Xinyuan-LilyGO/T-Echo/firmware/README.MD

<div align="center" markdown="1">
  LilyGo logo
</div>

<h1 align = "center">🌟 T-Echo Firmware 🌟</h1>

## 📖 Table of Contents

- [📖 Table of Contents](#-table-of-contents)
- [📋 Firmware Overview](#-firmware-overview)
- [📁 Firmware Directory Structure](#-firmware-directory-structure)
- [🔄 How to Update Firmware](#-how-to-update-firmware)

---

## 📋 Firmware Overview

| Firmware File | Description |
| :--- | :--- |
| `factory-xxx.uf2` | Includes LoRa transceiver, BLE connection, and all hardware test items. For BLE testing, download [nRF Connect](https://www.nordicsemi.com/Products/Development-tools/nrf-connect-for-mobile) from Google Play or Apple App Store. |
| `gps_factory.uf2`  | Used to diagnose hardware issues and test GPS functionality. |

---

## 📁 Firmware Directory Structure

```
firmware/
├── factory
│   ├── SoftRF-firmware-v1.3-nRF52.uf2      # SoftRF factory pre-flashed version
│   └── firmware-t-echo-inkhud-2.7.13.uf2   # Meshtastic factory pre-flashed version
├── factory-debug.uf2   # Factory test firmware
├── factory.uf2         # Factory debug test firmware
├── gps_factory.uf2     # GPS NMEA output firmware
```
> [!TIP]
> `factory-debug.uf2` prevents the device from booting until a serial monitor is connected. The device will not start unless a serial monitor is attached; once connected, it will begin booting and outputting diagnostic logs. Please note that for most serial monitors, you must enable the **DTR** option to view the logs output by the T-Echo. The serial monitor baud rate should be set to 115200.
> 

---

## 🔄 How to Update Firmware

1. Connect the device to your computer using a USB-C to USB-A cable (do not use USB-C to USB-C).
2. Double-click the top-left button on the device. If it doesn't work, try again.
3. Once the device disk appears on your computer, drag the `*.uf2` firmware file onto the disk and wait for the file to copy.
4. The device will boot normally.
