Xinyuan-LilyGO/T-Echo/dimensions/README.md

# T-BHI260-ICM29048

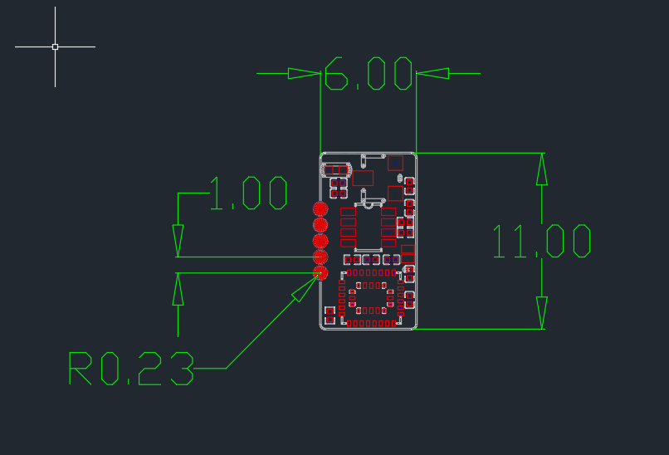
[picture p8: dimensions/T-BHI260.png]
T-BHI260


# T-Echo-Plus

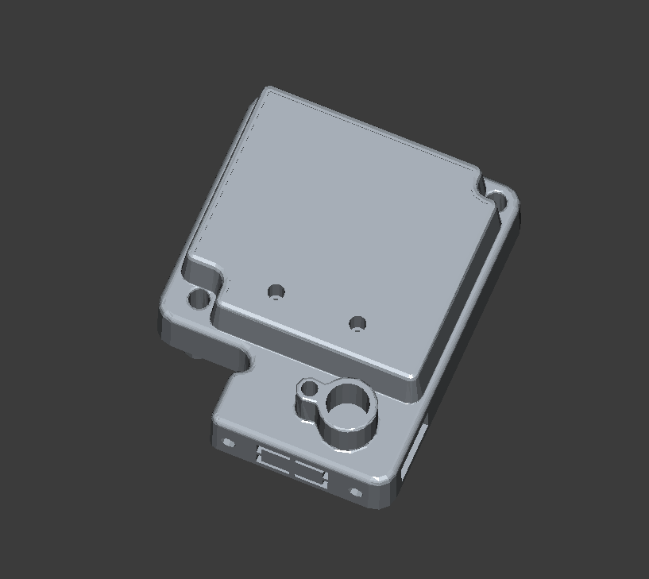
[picture p9: dimensions/t-echo-plus-back-cover.png]
t-echo-plus-back-cover


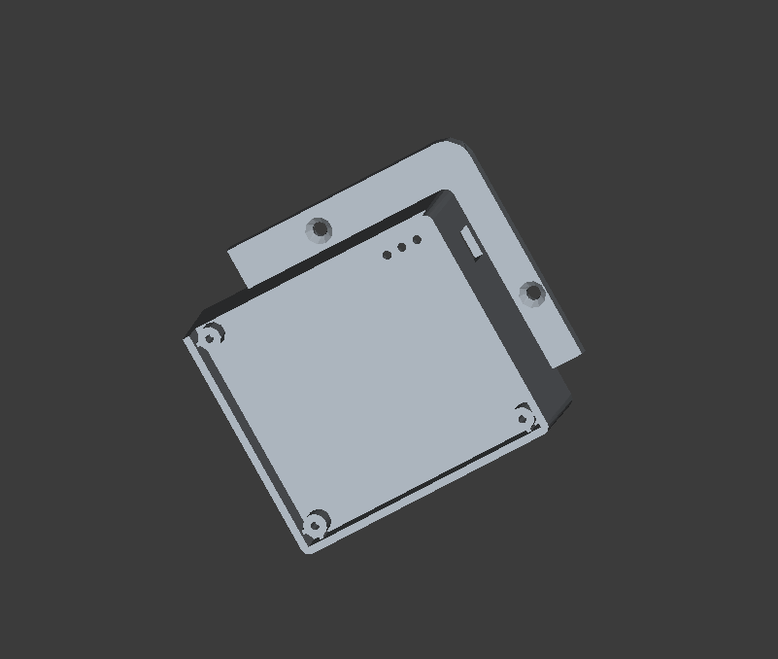
[picture p10: dimensions/t-echo-plus-middle-frame.png]
t-echo-plus-middle-frame
