Xinyuan-LilyGO/T-Echo/uf2/README.MD

- CURRENT.UF2 is placed here as a backup of t-echo [Refer to this issue](https://github.com/cfr34k/t-echo-lora-aprs/issues/30#issuecomment-3091227024)
