Xinyuan-LilyGO/T-Echo/examples/SoftRF_firmware/README.MD

<h1 align = "center">🌟LilyGo T-ECHO🌟</h1>

Double-click the reset button to pull the file into the popover's directory

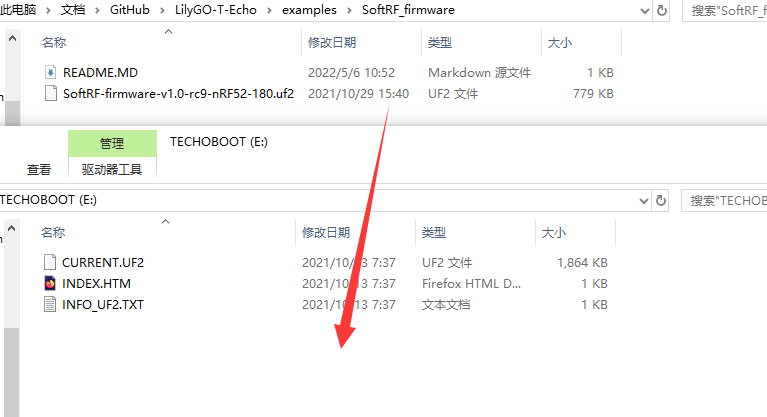
[picture p13: image/drag.png]


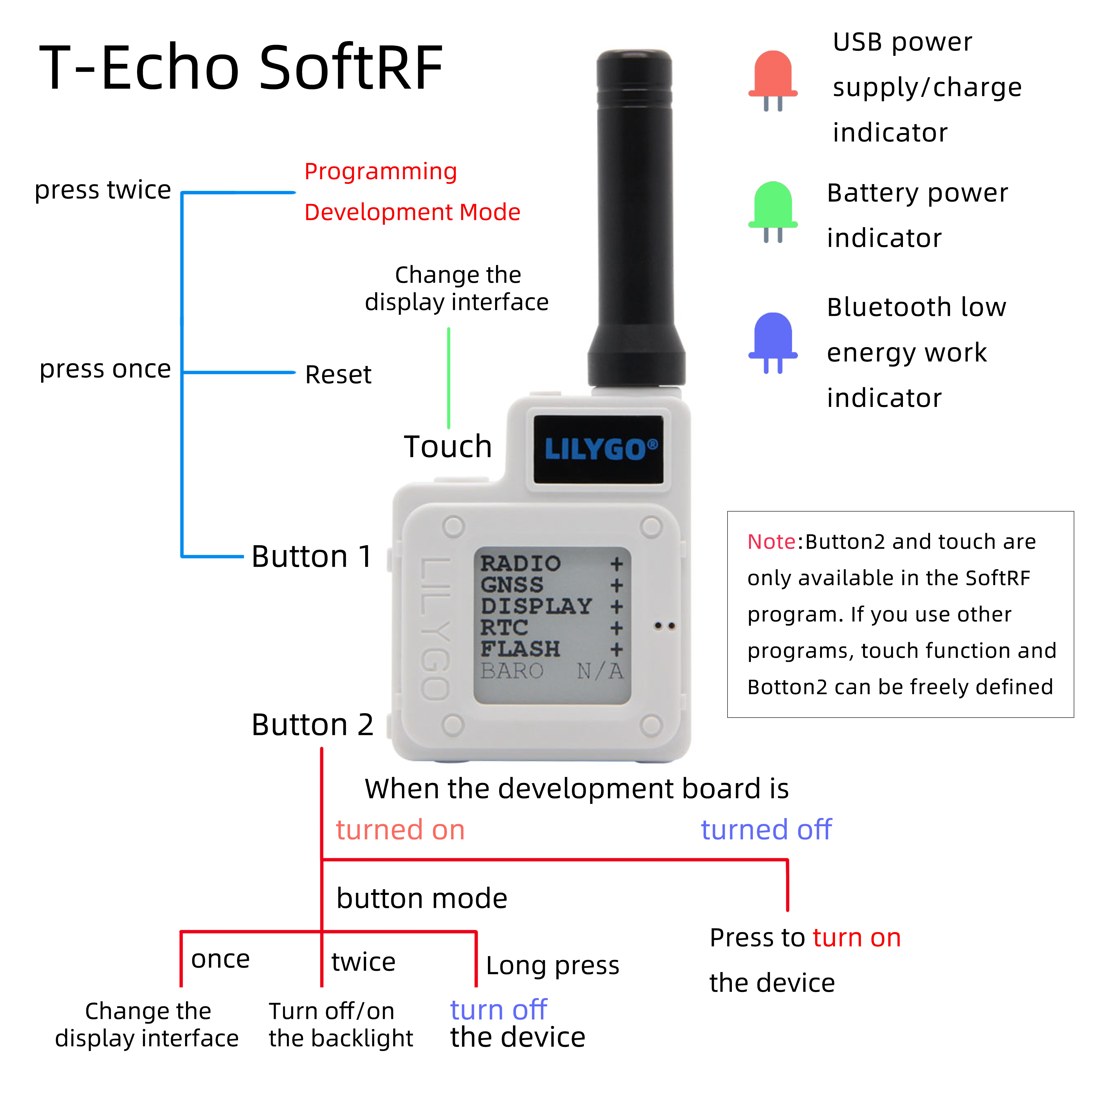
[picture p14: image/T-Echo_SoftRF.jpg]


- [T-Echo SoftRF](https://github.com/lyusupov/SoftRF)
- [T-Echo SoftRF Wiki](https://github.com/lyusupov/SoftRF/wiki/Badge-Edition)
