Xinyuan-LilyGO/T-Echo/examples/LoraReceive/README.MD

<h1 align = "center">🌟LilyGo T-ECHO🌟</h1>

This test requires two devices, one for the sender and the other for the receiver.Here is an example of the receiver.The serial output is as follows.
