Xinyuan-LilyGO/T-Echo/examples/LoraTransmit/README.MD

<h1 align = "center">🌟LilyGo T-ECHO🌟</h1>

This test requires two devices, one for the sender and the other for the receiver.Here's an example of the sending side.The serial output is as follows.
