Xinyuan-LilyGO/T-Echo/examples/GPS/README.MD

<h1 align = "center">🌟LilyGo T-ECHO🌟</h1>

This is a simple test of GPS, hook up the GNSS antenna.The output of successfully locating the serial port is as follows

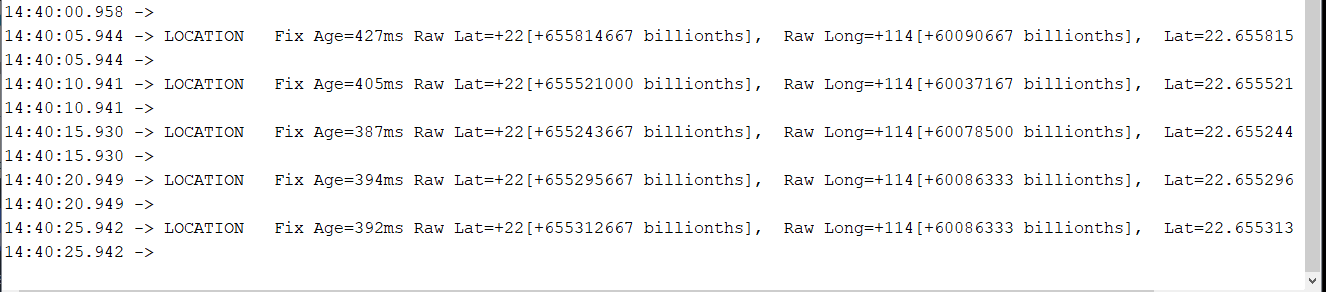
[picture p15: image/GPS.png]
