Xinyuan-LilyGO/T-Echo/examples/Sleep/readme.MD

<h1 align = "center">🌟LilyGo T-ECHO🌟</h1>
1. Long press the UserButton to sleep
2. Click and touch wake up
