Xinyuan-LilyGO/T-Echo/examples/Meshtastic_firmware/README.MD

<h1 align = "center">🌟LilyGo T-ECHO🌟</h1>

### Double-click reset to operate as shown in the figure below

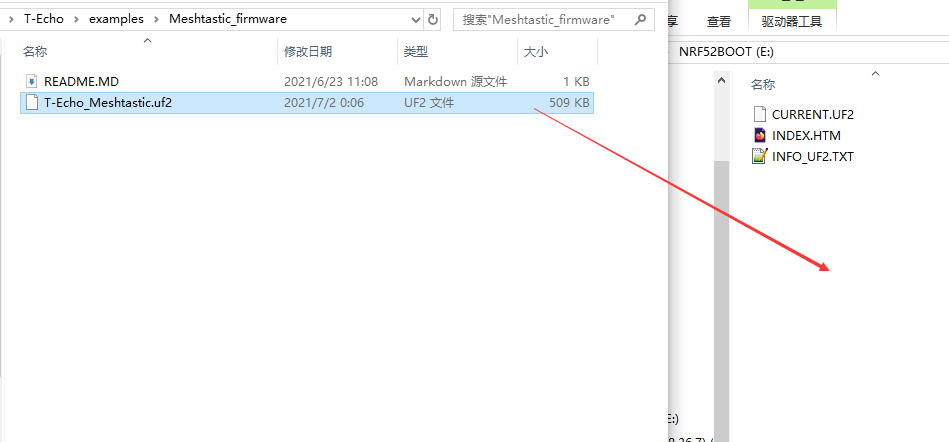
[picture p16: image/Meshtastic_pull.png]


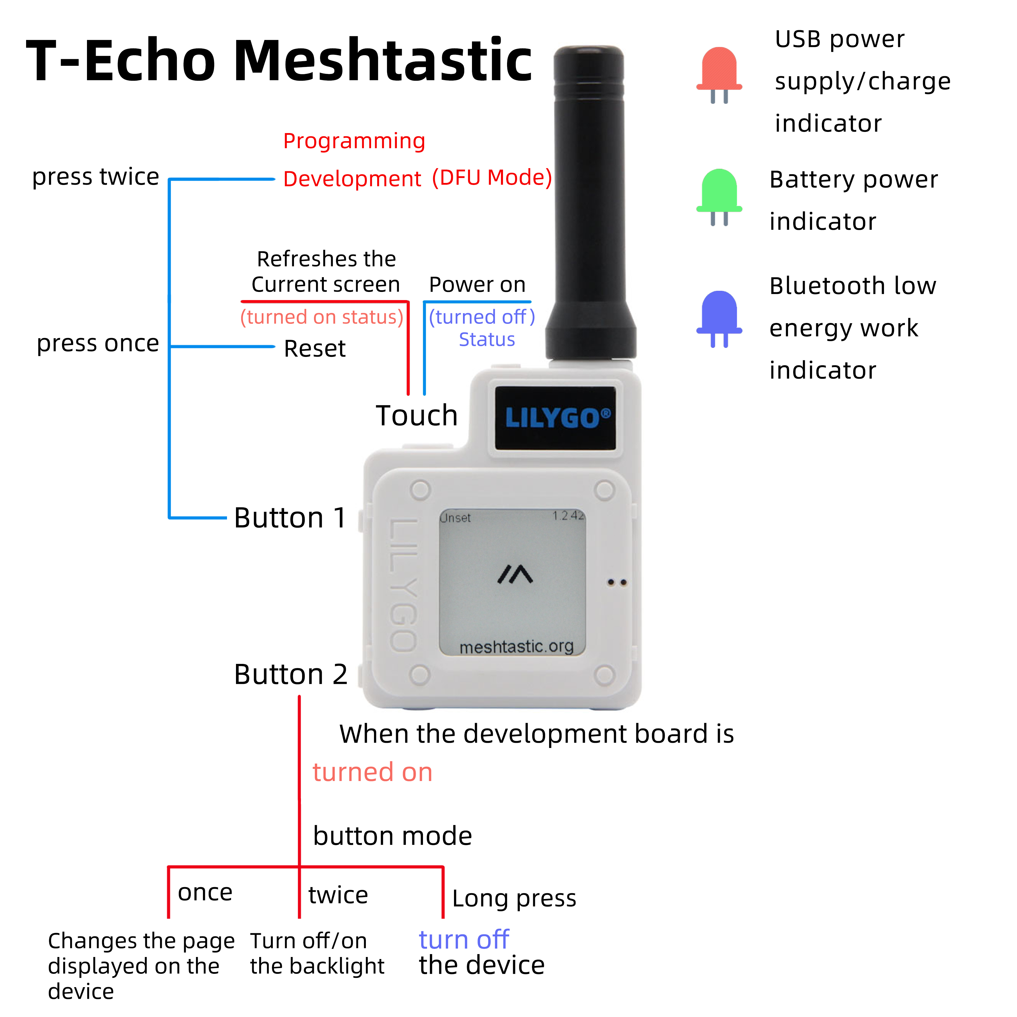
[picture p17: image/T-ECHO_Mesh.jpg]

- [T-Echo Meshtastic](https://github.com/meshtastic/Meshtastic-device/tree/v1.2.42.2759c8d)
- [T-Echo Meshtastic Doc](https://meshtastic.org/docs/getting-started)
- [T-Echo Meshtastic Android application usage](https://meshtastic.org/docs/software/android/android-usage)
