Xinyuan-LilyGO/T-Echo/image/lora_rx.png

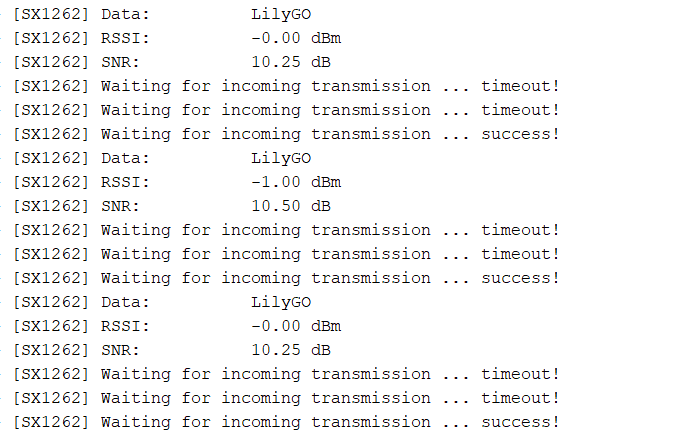
image/lora_rx.png
