Xinyuan-LilyGO/T-Echo/image/lora_tx.png

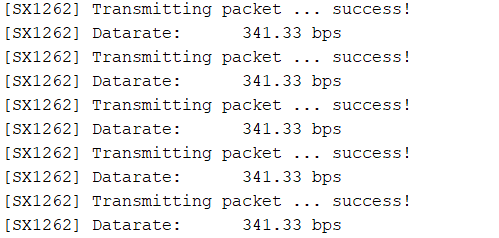
image/lora_tx.png
