Xinyuan-LilyGO/T-Echo/dimensions/T-BHI260-ICM29048.dxf

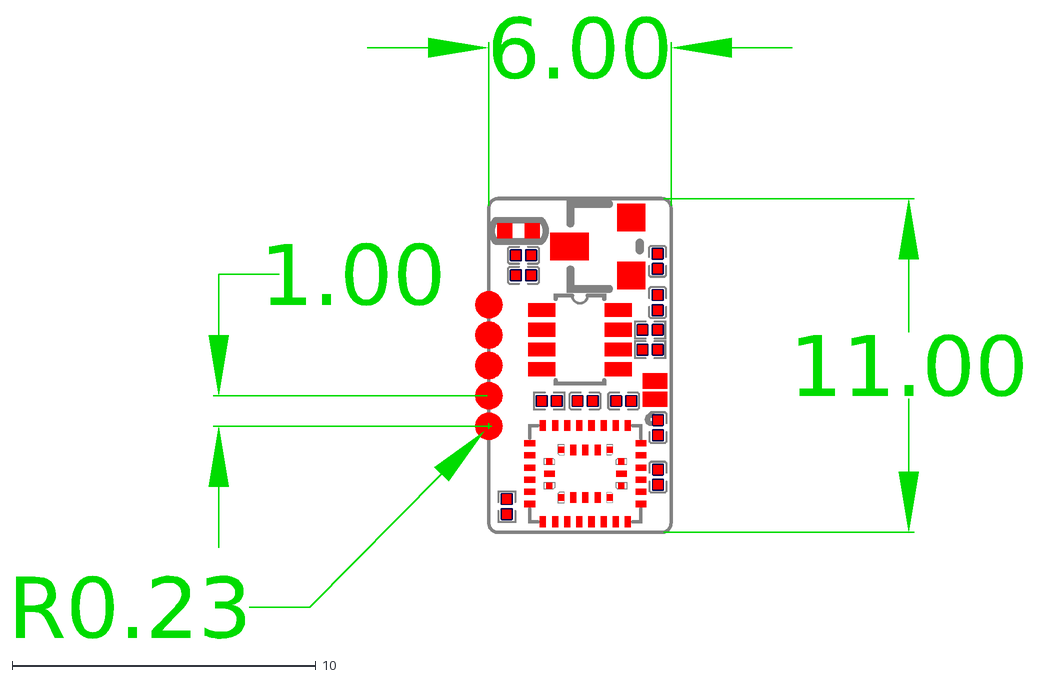
[picture p21: CAD file, 2025-06-24]
dimensions/T-BHI260-ICM29048.dxf
6.00
R0.23
11.00
1.00
