Xinyuan-LilyGO/T-Echo/dimensions/t-echo_3d.stl

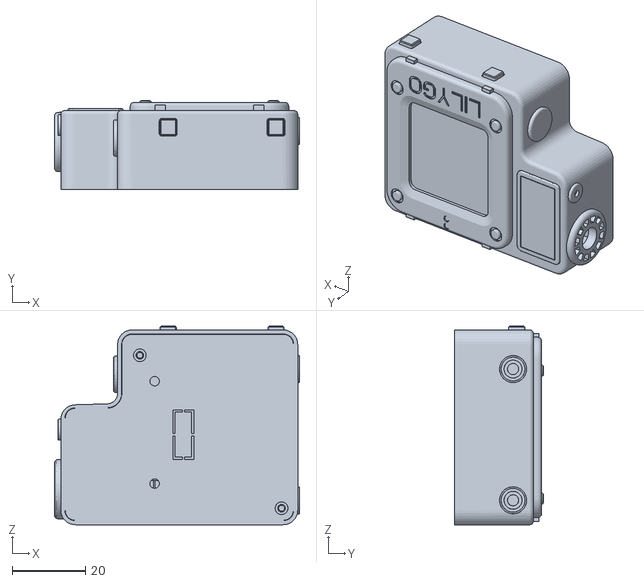
[picture p22: CAD file, 2022-05-06]
dimensions/t-echo_3d.stl
67.0 x 24.2 x 54.3
