Xinyuan-LilyGO/T-Echo/(threads)

Thread 1 (2021-08-01):

Arduino configuration for LoRa transmit program

F4EWI, 2021-08-01:
I just received my T-Echo. I need a little help setting up my development environment correctly.
1) Installation of libraries

- **PCF8563_Library** -> can you give more details on which to use (link, version,...)?
- Same remark for the **SoftSPI** and **SerialFlash_ID539** ?

2) Compilation error

Arduino: 1.8.15 (Windows 10), Board: "Nordic nRF52840DK (PCA10056), S140 6.1.1, Level 0 (Release)"
Transmit:17:10: fatal error: GxDEPG0150BN/GxDEPG0150BN.h: No such file or directory
   17 | #include <GxDEPG0150BN/GxDEPG0150BN.h>  // 1.54" b/w
      |          ^~~~~~~~~~~~~~~~~~~~~~~~~~~~~
compilation terminated.
exit status 1

GxDEPG0150BN/GxDEPG0150BN.h: No such file or directory

On my folder : C:\Users\HP\Documents\Arduino\libraries\GxEPD\src, I don't have this folder !

LilyGO, 2021-08-03:
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

The GxDEPG0150BN driver has been added. In [LilyGO-T-Echo/lib/GxEPD /](https://github.com/Xinyuan-LilyGO/LilyGO-T-Echo/tree/main/lib/GxEPD)

Closed 2021-09-02.

Thread 2 (2021-09-06):

LoRaWAN support

hkicko, 2021-09-06:
Could you please add an example using LoRaWAN?
I found 2 libraries that support this radio -
https://github.com/LacunaSpace/basicmac
and
https://github.com/ngraziano/LMICPP-Arduino
BasicMac seems more promising. But if I try to use it, it fails the assert in this method in radio-ax126x.c:
```
// reset radio
static void radio_reset (void) {
    // drive RST pin low
    bool has_reset = hal_pin_rst(0);

    // If reset is not connected, just continue and hope for the best
    if (!has_reset)
        return;

    // wait > 100us
    hal_waitUntil(os_getTime() + ms2osticks(1));

    // configure RST pin floating
    hal_pin_rst(2);

    // wait 1ms?
    hal_waitUntil(os_getTime() + ms2osticks(1));

    // check reset value
    ASSERT( ReadReg(REG_LORASYNCWORDLSB) == 0x24 );

    // initialize state
    state.sleeping = 0;
}
```

FabTangi, 2021-09-10:
could you also confirm this device can be used on The Things Industries / Networks ?

hkicko, 2021-09-10:
Yes, that's the goal - to use it as a mapper for Helium or TTN.

LilyGO, 2021-09-13:
Hello, thank you for your proposal. We are increasing the support of loRaWAN for T-Echo. If you gain anything, you are welcome to contribute to T-Echo.

wbefield, 2022-01-14:
I have a T-echo and would like to use it on the Helium network Mapper

MAY4VFX, 2023-12-03:
> https://github.com/Xinyuan-LilyGO/T-Echo/tree/main/examples/LoRaWAN
such a path does not exist, does T-echo TTN support any news?

Closed 2022-07-12.

Thread 3 (2021-09-10):

DeepSleep power consumption

FabTangi, 2021-09-10:
Can we have detailed infos on the power consumption of the product? (working / deepsleep)

LilyGO, 2021-09-11:
Working current: refer to https://github.com/lyusupov/SoftRF/wiki/Badge-Edition#battery-life
Sleep current: about 0.25mA

FabTangi, 2021-09-13:
Thanks for your answer. I was expecting a few microA, according to datasheets of components. Do you have plan to reduce the consumption in deep-sleep?

LilyGO, 2021-10-19:
Hi, There are no plans, and its sleep power consumption is already very low

Llgok, 2024-09-09:
> Thanks for your answer. I was expecting a few microA, according to datasheets of components. Do you have plan to reduce the consumption in deep-sleep?

@FabTangi
Hello, the latest low-power example has been updated. You can try using the example [Sleep\_Display](./examples/Sleep_Display) to reduce the power consumption of your onboard board.

Closed 2021-10-19.

Thread 5 (2021-11-11):

Error with lib/SoftSPI: Missing 'paragraph' from library

runestone74, 2021-11-11:
When starting Arduino I get this error (after adding the files from /lib to \Arduino\libraries) SoftSPI: Missing 'paragraph' from library

LilyGO, 2021-11-16:
[Download and unzip to the library](https://github.com/MajenkoLibraries/SoftSPI)

Closed 2021-11-16.

Thread 6 (2021-11-16):

Source code for the t-echo 1.2.42.753ae00-d.uf2 firmware

runestone74, 2021-11-16:
Hi, I am sorry but I can't find the source code.

runestone74, 2021-11-16:
We are eager to get the "reset without USB-power" working again :)

LilyGO, 2021-11-18:
[Reference](https://github.com/meshtastic/Meshtastic-device)

runestone74, 2021-11-19:
Thanks, I was searching for the source for this specific release: 1.2.42.753ae00-d where the "magic" reset button works as intended. Now it just works when USB power is plugged in. The UF2 files is available for download, but not the source code.

LilyGO, 2021-11-20:
This is the source code for Meshtastic .  [Reference](https://github.com/meshtastic/Meshtastic-device)

runestone74, 2021-11-21:
Yes but I can't find this specific release, do you have a direct link?

LilyGO, 2021-11-22:
[Reference](https://github.com/meshtastic/Meshtastic-device/releases)

runestone74, 2022-01-27:
There is no source code on github for release 1.2.42.753ae00-d can you search your backups and see if it turns up? :)

runestone74, 2022-02-02:
It seems like the GPS functionality is working much more reliable as well. Can you please publish this source code, thanks!

mkinney, 2022-02-04:
There are two software components: the bootloader (which is developed by the manufacturer LilyGO) and the firmware (could be made by anyone). I think, based on the version you're referencing, and the fact that they're pointing you to Meshtastic, I think you're looking for something like this: https://github.com/meshtastic/Meshtastic-device/releases/tag/v1.2.42.2759c8d

which is not made by LilyGo. It is made by the Meshtastic project (all volunteers)

However, that's fairly old in Meshtastic timeline. If you want to update to the latest, check out https://github.com/meshtastic/Meshtastic-device/releases/tag/v1.2.53.19c1f9f (or maybe the beta)

runestone74, 2022-02-09:
Still no source from LilyGO, with the changes that makes the T-Echo able to wake from sleep/reset . Also probably some other GPS communication as well. Yes, we understand that you might not want to share the sourcecode, but could you please point us in the right direction in the way it should work, but dont. That would be appreciated.

mkinney, 2022-02-10:
Check out this answer: https://github.com/Xinyuan-LilyGO/LilyGO-T-Echo/issues/9#issuecomment-1034425178

mc-hamster, 2022-04-19:
@runestone74 here you go:

https://github.com/geeksville/Meshtastic-esp32/commit/753ae00

Closed 2022-03-21.

Thread 7 (2021-11-22):

Drawing text on epaper display

CharlesMod, 2021-11-22:
Hello,

I've been trying for some time to successfully show text on the display, can you provide an example that shows how to do this?

LilyGO, 2021-11-22:
Here is a simple display  [example](https://github.com/Xinyuan-LilyGO/LilyGO-T-Echo/blob/main/examples/Display_lilygo/Display_lilygo.ino)

CharlesMod, 2021-11-22:
Thank you for your quick response!

I have already tried this example, trouble is it only shows bitmap print feature, not text print feature. Can you provide a different example?

CharlesMod, 2021-11-22:
FYI tested the following, just makes the code hang when included in the example you provided:

`  display->setRotation(2);
  display->fillScreen(GxEPD_WHITE);
  display->setTextColor(GxEPD_BLACK);
  display->setFont(&FreeSansBold9pt7b);
  display->setCursor(0, 45);
  display->print("Hello World"); //crashes here
  display->update();`

LilyGO, 2021-11-22:
void setup()
{
    Serial.begin(115200);
    delay(200);
    boardInit();
    delay(200);
    LilyGo_logo();
/*************************************************/
delay(200);
display->setRotation(3);
display->fillScreen(GxEPD_WHITE);
display->setTextColor(GxEPD_BLACK);
display->setFont(&FreeMonoBold12pt7b);
display->setCursor(0, 45);
display->print("Hello World"); //crashes here
display->update();
/*************************************************/
}

CharlesMod, 2021-11-22:
Hm no dice, the //crashes here line when uncommented breaks the sketch, the RGB blinking stops

Here is the full code, does it work on a unit you have there?

```
/*
  Display lilygo logo example

  This example shows an e-Peper display.The RGB indicator blinks in cycles.

  This example code is in the public domain.
*/

#include "utilities.h"
#include <SPI.h>
#include <Wire.h>

#include <GxEPD.h>
//#include <GxGDEP015OC1/GxGDEP015OC1.h>    // 1.54" b/w
//#include <GxGDEH0154D67/GxGDEH0154D67.h>  // 1.54" b/w
#include <GxDEPG0150BN/GxDEPG0150BN.h>  // 1.54" b/w

#include GxEPD_BitmapExamples
#include <Fonts/FreeMonoBold12pt7b.h>
#include <GxIO/GxIO_SPI/GxIO_SPI.h>
#include <GxIO/GxIO.h>

void setupDisplay();
void enableBacklight();
void configVDD(void);
void boardInit();
void LilyGo_logo(void);

SPIClass        *dispPort  = nullptr;
SPIClass        *rfPort    = nullptr;
GxIO_Class      *io        = nullptr;
GxEPD_Class     *display   = nullptr;

uint32_t        blinkMillis = 0;
uint8_t rgb = 0;

void setup()
{
  Serial.begin(115200);
  delay(200);
  boardInit();
  delay(200);
  LilyGo_logo();
  delay(200);
  display->setRotation(3);
  display->fillScreen(GxEPD_WHITE);
  display->setTextColor(GxEPD_BLACK);
  display->setFont(&FreeMonoBold12pt7b);
  display->setCursor(0, 45);
  display->print("Hello World"); //crashes here
  display->update();
}

void loop()
{

  if (millis() - blinkMillis > 1000) {

    blinkMillis = millis();
    switch (rgb) {
      case 0:
        digitalWrite(GreenLed_Pin, LOW);
        digitalWrite(RedLed_Pin, HIGH);
        digitalWrite(BlueLed_Pin, HIGH);
        break;
      case 1:
        digitalWrite(GreenLed_Pin, HIGH);
        digitalWrite(RedLed_Pin, LOW);
        digitalWrite(BlueLed_Pin, HIGH);
        break;
      case 2:
        digitalWrite(GreenLed_Pin, HIGH);
        digitalWrite(RedLed_Pin, HIGH);
        digitalWrite(BlueLed_Pin, LOW);
        break;
      default :
        break;
    }
    rgb++;
    rgb %= 3;
  }
}

void LilyGo_logo(void)
{

  display->fillScreen(GxEPD_WHITE);
  display->drawExampleBitmap(BitmapExample1, 0, 0, GxEPD_WIDTH, GxEPD_HEIGHT, GxEPD_BLACK);
  display->update();
}

void enableBacklight(bool en)
{
  digitalWrite(ePaper_Backlight, en);
}

void setupDisplay()
{
  dispPort = new SPIClass(
    /*SPIPORT*/NRF_SPIM2,
    /*MISO*/ ePaper_Miso,
    /*SCLK*/ePaper_Sclk,
    /*MOSI*/ePaper_Mosi);

  io = new GxIO_Class(
    *dispPort,
    /*CS*/ ePaper_Cs,
    /*DC*/ ePaper_Dc,
    /*RST*/ePaper_Rst);

  display = new GxEPD_Class(
    *io,
    /*RST*/ ePaper_Rst,
    /*BUSY*/ ePaper_Busy);

  dispPort->begin();
  display->init(/*115200*/);
  display->setRotation(2);
  display->fillScreen(GxEPD_WHITE);
  display->setTextColor(GxEPD_BLACK);
  display->setFont(&FreeMonoBold12pt7b);
}

void configVDD(void)
{
  // Configure UICR_REGOUT0 register only if it is set to default value.
  if ((NRF_UICR->REGOUT0 & UICR_REGOUT0_VOUT_Msk) ==
      (UICR_REGOUT0_VOUT_DEFAULT << UICR_REGOUT0_VOUT_Pos)) {
    NRF_NVMC->CONFIG = NVMC_CONFIG_WEN_Wen;
    while (NRF_NVMC->READY == NVMC_READY_READY_Busy) {}

    NRF_UICR->REGOUT0 = (NRF_UICR->REGOUT0 & ~((uint32_t)UICR_REGOUT0_VOUT_Msk)) |
                        (UICR_REGOUT0_VOUT_3V3 << UICR_REGOUT0_VOUT_Pos);

    NRF_NVMC->CONFIG = NVMC_CONFIG_WEN_Ren;
    while (NRF_NVMC->READY == NVMC_READY_READY_Busy) {}

    // System reset is needed to update UICR registers.
    NVIC_SystemReset();
  }
}

void boardInit()
{

  uint8_t rlst = 0;

#ifdef HIGH_VOLTAGE
  configVDD();
#endif

  SerialMon.begin(MONITOR_SPEED);
  // delay(5000);
  // while (!SerialMon);
  SerialMon.println("Start\n");

  uint32_t reset_reason;
  sd_power_reset_reason_get(&reset_reason);
  SerialMon.print("sd_power_reset_reason_get:");
  SerialMon.println(reset_reason, HEX);

  pinMode(Power_Enable_Pin, OUTPUT);
  digitalWrite(Power_Enable_Pin, HIGH);

  pinMode(ePaper_Backlight, OUTPUT);
  //enableBacklight(true); //ON backlight
  enableBacklight(false); //OFF  backlight

  pinMode(GreenLed_Pin, OUTPUT);
  pinMode(RedLed_Pin, OUTPUT);
  pinMode(BlueLed_Pin, OUTPUT);

  pinMode(UserButton_Pin, INPUT_PULLUP);
  pinMode(Touch_Pin, INPUT_PULLUP);

  int i = 10;
  while (i--) {
    digitalWrite(GreenLed_Pin, !digitalRead(GreenLed_Pin));
    digitalWrite(RedLed_Pin, !digitalRead(RedLed_Pin));
    digitalWrite(BlueLed_Pin, !digitalRead(BlueLed_Pin));
    delay(300);
  }
  digitalWrite(GreenLed_Pin, HIGH);
  digitalWrite(RedLed_Pin, HIGH);
  digitalWrite(BlueLed_Pin, HIGH);

  setupDisplay();
}
```

LilyGO, 2021-11-22:
I use your code. The normal operation. Are your factory firmware devices running properly?

CharlesMod, 2021-11-22:
I received 2 units in my order, one has a barely legible dim screen so I can't use that one, the other appears to work fine. If you send a compiled hex file, I could upload that to my hardware and check for functionality that way and get back to you

LilyGO, 2021-11-23:
Refer to [this ](https://github.com/Xinyuan-LilyGO/LilyGO-T-Echo/tree/main/examples/SoftRF_firmware) for uploading firmware

CharlesMod, 2021-11-24:
I've installed the firmware, the display on one appears to work just fine while the other is still very dim. I'm going to try to clean my installation directory for arduino and try the code I linked above again

CharlesMod, 2021-11-24:
Hm no dice, I cleared all of my libraries and reinstalled fresh from the lib folder but the device still says "LilyGo" rather than a blank screen with the words "hello world" shown as expected.

[https://photos.app.goo.gl/YWjZ4oDC6KqnJfj6A](image of screen I'm seeing)

LilyGO, 2021-12-04:
One shows normal.One that's very dark?Are these two e-papers the same batch?

CharlesMod, 2021-12-06:
More like very dim than dark yes, they were included in the same shipment.

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

LilyGO, 2021-12-07:
Can you see the interface label of e-paper?  They are SYX......  ?

CharlesMod, 2021-12-07:
Opened up the two units to take a look, both boards are the same revision,
2021-6-28 (V1.0)

The displays are both SYX 2118 according to the screenprinting on the
ribbon cable. Other information is the same on both displays as well

HINK-E0154A07-A1
Date:2017-02-28
SYX 2118

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

CharlesMod, 2021-12-07:
Can you confirm the display driver library I should be using for this
particular screen?

Choices from the example sketches are:

#include <GxEPD.h>
//#include <GxGDEP015OC1/GxGDEP015OC1.h>    // 1.54" b/w
//#include <GxGDEH0154D67/GxGDEH0154D67.h>  // 1.54" b/w
#include <GxDEPG0150BN/GxDEPG0150BN.h>  // 1.54" b/w

On Tue, Dec 7, 2021 at 9:41 AM Charles Dean Modrich ***@***.***>
wrote:

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

LilyGO, 2021-12-10:
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
You chose the right driver

CharlesMod, 2021-12-10:
Hm okay, I still haven't been able to successfully draw text on these
screens unfortunately, do you have any other troubleshooting suggestions?

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

mkinney, 2022-02-04:
You could drop Meshtastic on the device(s) to see if the screen works. (grab the uf2 file in the firmware.zip file) https://github.com/meshtastic/Meshtastic-device/releases/tag/v1.2.53.19c1f9f

CharlesMod, 2022-02-04:
I've done so and the screen definitely works (though one of my units has a
screen that's super dim), but the issue is getting fresh code to compile
and push text to the screen successfully.

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

piotr-kubica, 2022-02-19:
Hi, I'm having the same issue. Seems it has something to do with AdafruitGfx lib
`
#include <SPI.h>
#include <GxEPD.h>

#include <GxGDE0213B72B/GxGDE0213B72B.h> // 2.13" b/w
#include <GxIO/GxIO_SPI/GxIO_SPI.h>
#include <GxIO/GxIO.h>

#define SPI_MOSI 23
#define SPI_MISO -1
#define SPI_CLK 18
#define ELINK_SS 5
#define ELINK_BUSY 4
#define ELINK_RESET 16
#define ELINK_DC 17

GxIO_Class io(SPI, ELINK_SS, ELINK_DC, ELINK_RESET);
GxEPD_Class display(io, ELINK_RESET, ELINK_BUSY);

#include <Fonts/FreeMonoBold9pt7b.h>

void setup() {
    Serial.begin(115200);
    Serial.println("\n\n=== hello world ===");

    Serial.print("init_display...");
    SPI.begin(SPI_CLK, SPI_MISO, SPI_MOSI, ELINK_SS);

    display.init();
    Serial.println(" completed");

    delay(3000);
    display.setRotation(3);
    display.setTextWrap(false);
    display.fillScreen(GxEPD_WHITE);
    display.setTextColor(GxEPD_BLACK);

    display.setFont(&FreeMonoBold9pt7b);
    display.setCursor(20, 20);

// crashes here
// display.print("text") causes core panic exception !
//    display.print(String("text"));

    // this works ok
    display.fillRect(10, 10, 10, 10, GxEPD_BLACK);

    // this works ok
    display.drawChar(20, 40, 'a', GxEPD_BLACK, GxEPD_WHITE, 1);
    display.drawChar(30, 40, 'b', GxEPD_BLACK, GxEPD_WHITE, 2);
    display.drawChar(40, 40, 'c', GxEPD_BLACK, GxEPD_WHITE, 3);

    // also crashes here...
//    display.write('d');

    display.update();
}

void loop() {
    // put your main code here, to run repeatedly:
}
`

LilyGO, 2022-02-21:
Do you use t-Echo? This is NRF52840, not ESP32.

piotr-kubica, 2022-02-21:
@LilyGO do you have drivers for LILYGO®TTGO T5 V2.3.1 _ 2.13? Let me know I will try. Maybe it works.
This worked perfectly before I wonder what has changed.

LilyGO, 2022-02-22:
https://github.com/Xinyuan-LilyGO/LilyGo-T5-Epaper-Series

Closed 2022-02-22.

Thread 9 (2022-02-04):

bootloader question

mkinney, 2022-02-04:
Thank you for providing the .hex file for the bootloader.

Can I create a uf2 using a tool like https://github.com/lancaster-university/codal/blob/master/utils/uf2conv.py and have it work okay on the T-Echo?

I ran this command:

```
% python3 uf2conv.py lilygo_techo_bootloader-0.6.1_s140_6.1.1.hex --convert --output techo.uf2
Converting to uf2, output size: 377856, start address: 0x0
Wrote 377856 bytes to techo.uf2
```

Ok to drop that uf2 file on to the device?

mkinney, 2022-02-04:
I tried copying that techo.uf2 file and it just copied the file to the device. So, no, it will not work.

Where can I get the uf2 bootloader that was used on my units?

```
contents of: INFO_UF2.TXT
UF2 Bootloader 0.6.1-2-g1224915 lib/nrfx (v2.0.0) lib/tinyusb (0.10.1-293-gaf8e5a90) lib/uf2 (remotes/origin/configupdate-9-gadbb8c7)
Model: LilyGo T-Echo
Board-ID: nRF52840-TEcho-v1
SoftDevice: S140 version 6.1.1
Date: Oct 13 2021
```

LilyGO, 2022-02-09:
Hello, you need to double click the reset button.  UF2 file drag to BOOT:

mkinney, 2022-02-09:
I understand that is how you update **firmware**. I'm asking about the location of the **bootloader**.

Where is the source/download for the **bootloader**?

LilyGO, 2022-02-10:
[Reference](https://github.com/lyusupov/Adafruit_nRF52_Bootloader/tree/master/src/boards/lilygo_techo)

mkinney, 2022-02-10:
Thanks. Closing issue.

Closed 2022-02-10.

Thread 10 (2022-02-22):

Bluetooth examples

F4EWI, 2022-02-22:
Did you have an example of a bluetooth program for the T-ECHO ?
Which library should I use?

LilyGO, 2022-02-23:
Hello. [reference](https://github.com/Xinyuan-LilyGO/LilyGO-T-Echo#using-arduino-ide)，When you're done. Examples can be found under arduino IDE example
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
s

F4EWI, 2022-02-23:
The idea is to have a T-Echo communicate with a T-Watch 2020 via Bluetooth. I found only examples with BLE (one way). What would be the best way to get there?
SerialToSerialBT on the T-Echo ?

LilyGO, 2022-02-24:
It has an example of BLE

F4EWI, 2022-02-25:
Which ?

LilyGO, 2022-02-26:
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

Closed 2022-03-21.

Thread 11 (2022-02-23):

AS923-2

roomme13, 2022-02-23:
Is this available to use on 923mHz?

LilyGO, 2022-02-23:
Carry SX1262. Officially, it's 150MHz to 960MHz

roomme13, 2022-02-23:
based on specification it only state for 868/915, but my country use AS923 instead.  can i use it?
if you said based on SX1262, so what's different from two options 868/915 and 433/470? can i use 433/470 board and only change on firmware to 923mHz?

LilyGO, 2022-03-21:
You need to use a suitable antenna

Closed 2022-03-21.

Thread 15 (2022-04-29):

README arduino instructions are out of date

logikal, 2022-04-29:
the Board to select instructions reference an item that doesn't exist.

https://github.com/Xinyuan-LilyGO/LilyGO-T-Echo/blob/main/README.MD?plain=1#L8

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

LilyGO, 2022-05-03:
Hello，You can select "Nordic nRF52840 DK"

liangyingy, 2022-05-31:
Updated readme, see #14.  thanks!

Closed 2022-05-31.

Thread 16 (2022-05-10):

Upload with platformio on Linux does not work

pjalocha, 2022-05-10:
The specified protocol jlink is not working, although the device is visible on the serial port /dev/ttyACM0

Configuring upload protocol...
AVAILABLE: blackmagic, cmsis-dap, jlink, nrfjprog, stlink
CURRENT: upload_protocol = jlink
Uploading .pio/build/nrf52840_dk_adafruit/firmware_signature.bin
SEGGER J-Link Commander V7.50a (Compiled Jul  8 2021 18:21:10)
DLL version V7.50a, compiled Jul  8 2021 18:20:53

J-Link Command File read successfully.
Processing script file...

J-Link connection not established yet but required for command.
Connecting to J-Link via USB...FAILED: Cannot connect to J-Link.

J-Link connection not established yet but required for command.
Connecting to J-Link via USB...FAILED: Failed to open DLL

J-Link connection not established yet but required for command.
Connecting to J-Link via USB...FAILED: Failed to open DLL

J-Link connection not established yet but required for command.
Connecting to J-Link via USB...FAILED: Failed to open DLL

Script processing completed.

LilyGO, 2022-05-11:
J-link is required

pjalocha, 2022-05-11:
Thus what exactly is required: I have T-Echo, connected to the USB port, it is recognized as /dev/ttyACM0, minicom works properly on this port, what else is needed to upload new code to the T-Echo ?

LilyGO, 2022-05-12:
J-link  download .  It's not a USB download. Arduino IDE can be downloaded via USB

LilyGO, 2022-05-12:
To change the configuration platformio.ini.
upload_protocol = nrfutil  .
Because the boot program is different.  Before downloading, double click the reset button to connect t-Echo to DFU mode

Closed 2022-05-31.

Thread 17 (2022-07-14):

Information on LEDs needed

surlyhacker, 2022-07-14:
I am really confused about the LEDs in this device.
Here are some questions:
1) how many total LEDs there are?
2) which ones are internal and which are external?  There is at least one internal blue LED that can be seen if you open the case or look through the hole on the back.  And clearly there are 2 external spots where LEDs can be seen.
3) What is the position of each LED in the device's case?
4) For each LED, is it single-color or are there any multi color LEDs?
5) What is the pin numbering for each LED?

Your existing pinout diagram shows this:
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

And that doesn't really answer most of my questions.

surlyhacker, 2022-07-14:
And if you are able to answer these questions, please also put the answers in widely accessible places and not just in this issue comments, such as:
1) On this github README
2) On your AliExpress listings
3) On your web site

GoldProto, 2022-08-06:
I am anticipating some answers on these issues as well. Especially curious as to why the blue LED seen inside the device runs non-stop when in sleep mode. A battery drain if you ask me...
This needs to be corrected.
Have you looked in the raw code to see if there are some lines to comment/uncomment to change the status of the internal LED's (not on the front)?

lewisxhe, 2023-04-14:
The blue light connected to GPS cannot be turned off. Unless the GPS is turned off, it cannot be turned off when the GPS is turned on.

lewisxhe, 2023-04-14:
GPS and Radio are controlled by P0.12, if this IO port is low level, then the GPS 1PPS light should not be on

surlyhacker, 2023-05-27:
I tried setting P0.12 to low during the Meshtastic shutdown code in my own fork of the firmware and it did not result in the 1PPS light turning off.  It was still on.  Why would this not work?

What about PWR_EN / P0.13 ?  Would that turn off the 1PPS LED?

lewisxhe, 2023-05-27:
1PPS cannot be closed.

Thread 18 (2022-07-30):

Possible bug with failing loading of meshtastic .UF2 files - BME 280 model only (update: not BME280 models only)

GoldProto, 2022-07-30:
I have a number of the non-BME 280 T-Echo devices, all functioning when received. I have 1 of the BME 280 models and 1 non-BME model that worked initially, but quit booting successfully immediately after updating the firmware. It sometimes partially boots for about 2-4 seconds (only the first boot after flashing new FW)- enough to activate a blue LED, refresh the screen and set the startup screen image, firmware #, etc.  But immediately a red light starts flashing (USB cable unplugged just before the glitch starts makes no difference) and most of the time starts repeatedly nonstop mounting/unmounting as a USB device on my laptop.
It does not work for any combination of firmware and bootloader hex/UF2 files I've tried. I've also tried compiling my own uf2 file from Meshtastic's main repo;  VSCode>PlatformIO>uf2conv.py>no success.
What is strange is that is that the SoftRF firmware runs perfectly (sensors, comms, everything) along with all the demos in this (Xinyuan-LiliyGO/T-Echo) repository's example folder.
Scratching my head. Would love to figure out what the bug is.
Can someone help me resolve this issue?
Thank you.

lyusupov, 2022-08-06:
https://github.com/meshtastic/Meshtastic-device/issues/1565

GoldProto, 2022-08-06:
Update:
I tried your suggestion Lyusupov (thanks for making SoftRf by the way!) but it did not help. I now have 1 BME280 T-Echo device and 1 non-BME280 T-Echo device that are acting up.

- Both units still successfully load and run SoftRF - no problem!

- The non-BME unit I can get to run Meshtastic 1.2.64 - 1.3.31.0084643 **only one time** (after loading the uf2 file) until I put it to sleep. After trying to wake it up, it will not wake/start and run Meshtastic. I have to use a strange method to make it work this way, otherwise I cannot get it to run any version of Meshtastic whatsoever. This is the strange method I use to make this happen;

1. Load [https://github.com/lyusupov/POST_TEcho/blob/main/bin/POST_T-Echo_CircuitPython6.uf2](url) to the non-BME280 device. (Device will not run the POST firmware)
2. Load T-echo bootloader (update-lilygo_techo_bootloader-0.6.1_nosd)
3. Load a version of Meshtastic 1.2.64 to version  1.3.31.0084643. (newest)
4. Device will start successfully and run Meshtastic for one instance until put to sleep by holding button 2 down(lower left corner on device) and will display the proper "sleeping" screen with logo and Meshtastic version displayed.
5. Device will not wake/reset and start Meshtastic.

- I Cannot get the BME280 device to run any version of Meshtastic. It gets stuck in a weird bootloop mounting and unmounting as a usb serial device to the laptop. The only firmware I can get it to run successfully are all the examples in this folder except the Meshtastic firmware.  Link; [https://github.com/Xinyuan-LilyGO/T-Echo/tree/main/examples](url)

A very strange bug indeed!

LilyGO, 2022-08-09:
Hello，This [bootloader ](https://github.com/Xinyuan-LilyGO/T-Echo/blob/main/bootloader/lilygo_techo_bootloader-0.6.1-no-button-dfu-140_6.1.1.hex)  is required to use Meshtastic to wake up with button 2

GoldProto, 2022-08-09:
Thank you. I'll convert to .uf2 and see if it works.

GoldProto, 2022-08-10:
Thank you LilyGO. I used uf2conv.py tool to convert LilyGO's linked bootloader,  but the new bootloader (with new .uf2 firmware dropped in) did not fix the problem. The bootloader you suggested stopped the boot looping problem.

One bad result is that I now cannot load and run the SoftRF program by @lyusupov .
The new INFO_UF2.TXT file has this text. The "SoftDevice: not found" probably is related to the new problem of not loading SoftRF.

`UF2 Bootloader 0.6.1-2-g1224915 lib/nrfx (v2.0.0) lib/tinyusb (0.10.1-293-gaf8e5a90) lib/uf2 (remotes/origin/configupdate-9-gadbb8c7)
Model: LilyGo T-Echo
Board-ID: nRF52840-TEcho-v1
SoftDevice: not found
Date: Oct 13 2021
`

In the uf2conv.py script I used this number (bold) and perhaps it is causing an issue:

`python uf2conv.py -f **0xADA52840** -c -o lilygo_techo_bootloader-0.6.1-no-button-dfu-140_6.1.1.uf2 lilygo_techo_bootloader-0.6.1-no-button-dfu-140_6.1.1.hex
Converted to uf2, output size: 6955520, start address: 0x2000
Wrote 6955520 bytes to lilygo_techo_bootloader-0.6.1-no-button-dfu-140_6.1.1.uf2`

Any suggestions on a fix would be great.

LilyGO, 2022-08-11:
1. If you use SoftRF. Use this bootload [lilygo_techo_bootloader-0.6.1_s140_6.1.1.hex](https://github.com/Xinyuan-LilyGO/T-Echo/blob/main/bootloader/lilygo_techo_bootloader-0.6.1_s140_6.1.1.hex)

3.If you want to use Meshtastic. And want to use the button to wake up. Use this bootload[lilygo_techo_bootloader-0.6.1-no-button-dfu-140_6.1.1.hex](https://github.com/Xinyuan-LilyGO/T-Echo/blob/main/bootloader/lilygo_techo_bootloader-0.6.1-no-button-dfu-140_6.1.1.hex)

GoldProto, 2024-05-29:
I was able to recover my 2 failed devices a few days ago... finally after 2 years of having "softbricked" devices that could only run SoftRF formware correctly, it is great to have them now running meshtastic flawlessly!

This is what I did;

1. Installed the latest bootloader via Arduino IDE following these instructions;

Update Bootloader with DFU
To upgrade to the latest Bootloader + Softdevice using the serial port within Arduino IDE.
Select Tools > Board > Adafruit Feather nRF52840 Express
Select Tools > Programmer > Bootloader DFU for Bluefruit nRF52
Select Tools > Burn Bootloader
WAIT until the process complete ~30 seconds
Note: close the Serial Monitor before you click "Burn Bootloader". Afterwards, you shouldn't close the Arduino IDE, unplug the Feather, launch Serial Monitor etc ... to abort the process. There is a high chance it will brick your device! Do this with care and caution.

2. Performed a reset of the flash storage on the device - IMPORTANT STEP; YOU MUST have the Python environment installed along with the meshtastic CLI. The CLI command "meshtastic --noproto...then press any key" in the steps below is a critical step for this to work successfully!!

To reset the flash storage on your nRF52 board:
Download and unzip the latest firmware from [Meshtastic Downloads](https://meshtastic.org/downloads).
Connect your device to your computer with a USB data cable.
Double click the reset button on your device (this will put it into bootloader mode)
Notice a new drive will be mounted on your computer (Windows, Mac, or Linux)
Open this drive and you should see three files: CURRENT.UF2, INDEX.HTM, and INFO_UF2.TXT
Find the file included in the downloaded firmware named Meshtastic_nRF52_factory_erase.uf2 and copy it onto the new drive. The device should reboot.
With the [Meshtastic CLI](https://meshtastic.org/docs/software/python/cli/) installed, open your Terminal/Console and enter the command: meshtastic --noproto.
Press any key, you should see the message: Formatting... Done.

3. Installed the latest .uf2 beta version of meshtastic here using drag and drop .uf2 firmware update method
(https://github.com/meshtastic/firmware/releases/tag/v2.3.10.d19607b)
(this version does not utilize the fuction of the touchsense button on the upper left corner of the t-echo device. Works great otherwise!)

@LilyGO , hope this solution can be passed on to other users that unintentionally softbrick their devices when trying a harmless .uf2 firmware upgrade!

Closed 2024-05-31.

Thread 21 (2023-02-24):

Any Information on P2 to connect something?

rudydevolder, 2023-02-24:
I can see next to the usb C port there's place for a 4 pin connector. I was hoping we could use this to connect something like a buzzer.

rudydevolder, 2023-02-25:
I found in the schematics this P2 connector is for SWD debugging.
But I have still wonder I could use these 2 pins as GPIO pins. Is there any risk or considerations to make?

lyusupov, 2023-03-02:
https://devzone.nordicsemi.com/f/nordic-q-a/5933/can-i-use-any-gpio-to-map-swd-pins

Thread 22 (2023-02-27):

CircuitPython Support?

jamesshannon, 2023-02-27:
Hi,

I bought a few T-Echo boards. I want to flash them and install some simple custom code on them for my club to track GPS coordinates and upload to a central device. If it works, my club will buy about 30 units.

I feel like it'd be much easier to develop in CircuitPython. Is CircuitPython supported? According to [this page](https://learn.adafruit.com/circuitpython-on-the-nrf52) it seems like the chipset is supported but LilyGO needs to [create a custom profile](https://learn.adafruit.com/circuitpython-on-the-nrf52#other-boards-3023986) with the T-Echo's specific pinout? Are there plans to do this? Is CircuitPython support as easy as this page suggests?

lyusupov, 2023-03-02:
1. https://github.com/lyusupov/POST_TEcho
2. https://github.com/Xinyuan-LilyGO/lilygo-micropython/commit/23f950eba4df35bda09601ef6c85cbe703e9fec3

Thread 24 (2023-05-24):

About the antenna

SCWhite, 2023-05-24:
HI, great project!

I'm wondering what's that component on the antenna ipx socket may be? and what's the usage of it?

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

also any suggest on choosing a better antenna for mt board?

thanks!

Thread 29 (2023-06-26):

How to disable the single blue (1PPS) LED

ajorg, 2023-06-26:
There is an explanation at https://github.com/meshtastic/firmware/issues/1493#issuecomment-1205024423 that seems to suggest that this blue LED cannot be disabled (not the blue LED from the tri-color LED, but the blue LED that's connected to the GPS 1PPS). But it's unclear if the meaning is that the LED cannot be disabled while the GPS is enabled, or if correctly disabling the GPS module should also disable the LED.

If disabling the GPS (or 1PPS) module correctly should disable its blue LED, clarification is needed as to the correct method of disabling the module.

If it's not possible, we'd appreciate positive confirmation that this blue LED cannot be disabled under any circumstance.

nxxxse, 2023-07-16:
I am also affected by this on my T-Echo with Mestastic 2.1.18. I continued where @richteel left of in https://github.com/meshtastic/firmware/issues/1493#issuecomment-1598008233. I checked with a Multimeter.

> Is the L76K really in standby?

Yes. https://github.com/meshtastic/firmware/blob/c75965480f9da9f067cf0d4722c06bf31ca7f959/src/gps/GPS.cpp#L629  works and pulls the WAKEUP pin on L76K to GND. I measured 0.0V. Meshtastic is off/in deep sleep and the internal blue LED is on. I measure 2.5 V on the 1PPS pin. I would have expected 3.3 V because that is VCC of L76K even in deep sleep of nrf52840.

RESET_N is 0 V … Interesting. Theory is that the GNSS module constantly resets and 1PPS is LOW in that state? I tested by putting:

```c
    digitalWrite(PIN_GPS_REINIT, 1);
    pinMode(PIN_GPS_REINIT, OUTPUT);
```

into `GPS::sleep()`. I confirmed that RESET_N is now 3.3 V with that patch in T-Echo deep sleep but still, the LED is still on.

What is interesting is that when T-Echo is on and I probe GND and RESET_N in voltage measuring mode, the internal blue LED comes on whenever I touch both pins. RESET_N seems quite sensitive and the high resistance of my multimeter is enough to trigger it. I measure 3.3 V so it is not like the ~1 MΩ of my multimeter would pull the pin down to GND. I don‘t have a oscilloscope here to look into this further.

> If it is, why is 1PPS held high?
> Is 1PPS really active low and should have the LED polarity flipped and connected to VCC rather than GND?
> Is it best to simply remove LED6? (Most likely this is the correct answer but I do not like to jump to conclusions. The previous questions need to be answered first.)

I did that now as a quick fix. I have spent too much time on this. Was a nice exercise though!

FabianMNoss, 2023-07-30:
@nxxxse I have a scope here, but had no time yet to go into the details of this bug yet. If you are interested, let's try together to sort this out?

Thread 32 (2023-10-02):

Intermittent GPS failure - solved

dc1rdb, 2023-10-02:
Just wanted to point out an assembly flaw that can lead to GPS not getting a fix at all or intermittently. I had that problem on my newly acquired unit and found out the following:
Looking at the board, in the upper left hand corner there is a stripe of conductive mesh tape connecting the SMA socket ground to the GPS chip shielding. On my unit, that mesh tape was also in contact with the passive components to the right of the GPS antenna receptacle on the board, effectively shortening them. There was a patch of isolating tape on top of the conductive mesh tape, which is just the wrong way around.
I placed the patch of isolating tape on the passive components between GPS chip and SMA socket and laid the conductive tape over it. The mesh tape still connects the SMA ground with the GPS chip shielding. Now the GPS performes flawlessly. The photo shows the area after the modification.

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

goedzo, 2024-09-09:
Do you by any chance have a before picture? I also seem to have issues in getting a GPS fix.

dc1rdb, 2024-09-10:
Sorry, I don't.
Just make sure there is isolating tape below the center portion of the conductive tape.
In addition, keep in mind that your very first GPS fix can take quite a long time (like 15 minutes) and the unit should be placed outside with clear view of the sky.

goedzo, 2024-09-10:
Thanks! I actually did open up the device to check it and I saw there was already a small piece of transparent tape under the mesh. So I guess they updated this already? And yes I also indeed notice that the first fix takes quite some time.

Thread 33 (2023-11-28):

bootloader crashing

chesc-I0, 2023-11-28:
When I double click the reset button and connect the t-echo to a PC using usb it mounts. When I attempt to copy the firmware to the device, the t-echo always unmounts itself before the firmware can be copied over.

How do I fix this?

Thread 35 (2024-01-08):

Connect to xcsoar

BrianJSavage, 2024-01-08:
I am trying to connect to xcsoar running on my phone.
I connect bluetooth and the device appears in the devices list but I only get No Data appearing.

I have checked all the NMEA options in the Tool setup.

Help!!

Cheers

brian

777CHIP, 2024-01-20:
I am having the exact same issue on both of my T-Echo’s … Softrf

would really like a response

lyusupov, 2024-02-03:
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

<br>
<br>
<br>

#

<br>
<br>
<br>

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

<br>
<br>
<br>

#

<br>
<br>
<br>

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

<br>
<br>
<br>

#

<br>
<br>
<br>

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

BrianJSavage, 2024-02-03:
Thanks for the reply.

I did all that, the only change was setting protocol to OGNTP.

Still doesn't work, and still getting No Data on the port.

Also, on my XCSOAR the device shows up as BLE Sensor, not BLE Port as shown above. Not sure if this makes a difference.
I also used channel A as shown, as shown above which disables the built in GPS and sensors.

Cheers

Brian

BrianJSavage, 2024-02-03:
I did unpair. reset everything and it didn't work when I replied before.
I just tried it again after your last comment, and it now works.
Thinking about it, the issue is that I thought I had to pair through Bluetooth, which I had to do to get SoftRF to work.
So it was still paired while I tried to attach to xcsoar.
Please confirm the solution is to not have it paired through Bluetooth, and it will connect.
This might be worth emphasising somewhere for other people, as to me it is counterintuitive.
Thanks for your help. Much appreciated.
Brian

lyusupov, 2024-02-03:
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

BrianJSavage, 2024-02-09:
Thanks for your help. All working

Closed 2024-02-09.

Thread 37 (2024-01-27):

T-Echo Won’t Run on Battery

drepamig, 2024-01-27:
I’m not sure if this is the correct place to ask this question, but hopefully someone can help. I have two T-Echos that were totally stock. I decided I wanted to upgrade the battery from the stock 102535 to a larger 103443. I initially bought the wrong connector size on the replacement batteries (1.5mm instead of 1.25 mm). I thought I might be able to swap the ends and keep the pins, but that failed, so I ended up cutting the connector off of the old battery and soldered it on to the new battery. In doing so, I found that the pins wouldn’t stay seated in the connector (because I tried to swap them earlier) and I ended up plugging in and unplugging the connector about a dozen times trying to get everything seated. During that time, the new battery would power on the T-Echo. I gave up on trying to re-use the connectors from the old battery and bought a 10 pack of new pigtails.

Fast forward a few days where I replaced the connectors and plugged the battery into my echo and nothing happened - no power, no lights, nothing.
- I checked the battery voltage (~4v)
- I checked the voltage from the battery connectors to the circuit boards (also ~4v matching the battery)
- The echos both run fine on USB
- Neither will run on battery, either the originals or the new ones
- The serial debug info on them say: `DEBUG | 20:58:33 148 [Power] Battery: usbPower=1, isCharging=1, batMv=4841, batPct=100`, so it appears that maybe they're detecting the battery, though `batMv=4841` doesn’t match the battery voltage. Is it the USB voltage? I get a flashing blue light on the left and a rapidly flashing amber/red light on the right, so that seems to indicate that the echo _isn't_ detecting the battery.
- I’ve factory reset and re-flashed both devices with no change.

Did I somehow kill the battery circuit on both of these devices? Does anyone have any other suggestions?

Thanks!

Thread 38 (2024-01-28):

When will more be in stock ?

m1ctk, 2024-01-28:
As subject, thanks !

lyusupov, 2024-02-03:
https://www.lilygo.cc/products/t-echo-nrf52840

#

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

m1ctk, 2024-02-03:
Thanks yes I noticed today, just ordered one

lyusupov, 2024-02-03:
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

Danie10, 2024-02-22:
I see the Ship By Date, but no option for Add to Cart. It just shows Sold Out in that area.

lyusupov, 2024-03-08:
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

<br>
<br>

1) https://www.lilygo.cc/products/t-echo
2) https://www.lilygo.cc/products/t-echo-nrf52840

Thread 41 (2024-04-18):

Active Display Light Doesn't Come On and Touch Button Doesn't Work

jdcollins3, 2024-04-18:
Just received the T-Echo and updated firmware to v2.3.4. The active display light will not come on after button one in pressed twice and screen flickers sometimes. Also, the top touch button does not operate.

beaugunderson, 2024-06-13:
Mine came flashed with 2.3.8 and the top button turned the light on, I upgraded to 2.3.11 and it no longer turns the light on (it seems to do nothing now). Any ideas?

Thread 42 (2024-05-03):

internal Flash Memory example??

richonguzman, 2024-05-03:
cant find any internal Flash Memory example to use this

lyusupov, 2024-05-10:
https://github.com/adafruit/Adafruit_SPIFlash

richonguzman, 2024-05-10:
> https://github.com/adafruit/Adafruit_SPIFlash

So I would need to read/write flash with flash examples or SDFlash examples?

PS: can flash memory be written with VSCODE>Platformio?

lyusupov, 2024-05-10:
> So I would need to read/write flash with flash examples ...

Access to T-Echo's 2 Mbytes QSPI flash memory is possible with FAT filesystem and USB Mass Storage method. See this example:

https://github.com/lyusupov/SoftRF/wiki/Badge-Edition.-Aircrafts-database

richonguzman, 2024-05-10:
so the flash data is added just the uf2 files when starting the USB Mass Storage method ??

on the same folder and all?

lyusupov, 2024-05-10:
1) the uif2 firmware binary is applicable when the device in Adafruit **bootloader mode** only
2) in application mode (Arduino) -it is possible to use the same 'Drag and Drop' method as well, read
   - Adafruit SPIflash examples and
   - Adafruit TinyUSB Arduino examples

richonguzman, 2024-05-10:
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

sorry I got lost for a moment:

My The T-echo is running as "Adafruit bootloader mode" and I can upload like a "external mass flash disk" the .uf2 file and also through VSCODE+Platformio. This works fine.

But this is where I need to be specific: will I be able to add also a .json file into the flash of T-echo by copying it also to the "external mass flash disk" that "Adafruit bootloader mode" enables?

lyusupov, 2024-05-10:
> will I be able to add also a .json file into the flash of T-echo by copying it also to the "external mass flash disk ...

Play with **msc_external_flash** sketch _(mentioned above)_ to answer your question by yourself.
You may borrow T-Echo specific GPIOs and flash types from SoftRF source code:
https://github.com/lyusupov/SoftRF/blob/master/software/firmware/source/SoftRF/src/platform/nRF52.cpp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

richonguzman, 2024-05-10:
> > will I be able to add also a .json file into the flash of T-echo by copying it also to the "external mass flash disk ...
>
> Play with **msc_external_flash** sketch _(mentioned above)_ to answer your question by yourself. You may borrow T-Echo specific GPIOs and flash types from SoftRF source code: https://github.com/lyusupov/SoftRF/blob/master/software/firmware/source/SoftRF/src/platform/nRF52.cpp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

thanks for the guidance!!!

 I will try (as this is all new to me)

 ;)

lyusupov, 2024-05-10:
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

Closed 2024-05-10.

Thread 43 (2024-05-05):

Tactile switch/screen connector part numbers

vitaminmoo, 2024-05-05:
Do you have the edge mount tactile switch part numbers available? I seem to have exploded mine and am not having luck finding a compatible part number for replacement.

Same with the board mount connector for the display - that came apart when I removed the battery (the adhesive tore it off)

vitaminmoo, 2024-05-05:
XF2M-2415-1A appears to be compatible with the ribbon cable connector

vitaminmoo, 2024-05-05:
P16763CT-ND looks maaaybe close enough to work on the tactile buttons

vitaminmoo, 2024-05-18:
Both are wrong - The switches are a doable fit, but the pads of each switch are grounded so it specifically needs to be a switch that bridges both the back contacts when pressed, not front to back or otherwise.

The ribbon cable connector is also wrong in two ways - it's not quite a fit length-wise for the mechanical pads, and I also miscounted so it's got two to many contacts

vitaminmoo, 2024-05-18:
FH12A-24S-0.5SH(55) actually looks really good for the fpc

smiba, 2024-07-02:
I'm having the same issue, I dropped my T-ECHO and one of the switches has destroyed itself upon impact.

Have you found a replacement part ?

vitaminmoo, 2024-07-08:
@smiba I unfortunately have not

vitaminmoo, 2024-07-09:
They may be 1TS003B-1400-3500A-CT - I'll update when I get my hands on some

joe-albanese, 2025-02-22:
I purchased the buttons @vitaminmoo mentioned and they work perfectly. They feel maybe a touch mushier, but that might just be because I soldered them on slightly crooked

Thread 46 (2024-06-09):

Screen not responding

josephmarino1, 2024-06-09:
Hi there,

Not sure if this is the right place to post. I recently unboxed a t-echo that I purchased a few months back. Since opening it, the screen has been stuck on the "Normal Off" screen. I have been able to update it to run Meshtastic 2.3.10.d19607b Beta, but I cannot pair it since the screen is unresponsive.

I have tried everything I could find online as far as wiping the device via meshtastic's file, re-flashing the firmware to different versions, and flashing the bootloader using Arduino IDE software, but the screen never changes.

Thanks!

Hal102, 2024-07-23:
Hi,
I am in the same situation, I received a new T-Echo yesterday and on powering up the screen has been unresponsive. I have managed to conduct an update to the latest Meshtastic release but have not been able to make the screen work.

danielemery, 2024-12-22:
I am experiencing the same issue, the e-ink display no longer refreshes. I have copied over the latest firmware using meshtastic flasher, but still no refreshed e-ink display so I am unsure of the state of the device. I cannot connect to it with bluetooth.

mbertazz, 2025-02-04:
Same issue here, screen is unresponsive and cannot connect via Bluetooth.

Thread 47 (2024-07-27):

T-Echo nonreactive with red LED pulsing

stefanthoss, 2024-07-27:
My T-Echo with Meshtastic 2.3.15 was running fine but in the middle of the night it just froze. No more Bluetooth connection and the device doesn't react to any button presses. The display just shows whatever it showed when it froze.

The left of the two red LEDs makes two pulses every 5 seconds and that's it. I tried the following without success:
* Flashing the latest stable version of Meshtastic. The device can be brought into DFU mode with a couple click of the top button and it accepts the firmware via file copy. But it doesn't change the behavior of being completely nonreactive.
* Trying to [update the bootloader](https://meshtastic.org/docs/getting-started/flashing-firmware/nrf52/update-techo-bootloader) doesn't work either, the device accepts the `.uf2` file, disconnects, and nothing happens.
* Disconnecting the battery for a couple of hours, reconnecting it, flashing the bootloader, and flashing Meshtastic.

Any idea how I can rescue the device?

stefanthoss, 2024-08-01:
Rescued the device with the following steps (only this exact order of steps seems to work):
1. Updating the [bootloader using adafruit-nrfutil](https://meshtastic.org/docs/getting-started/flashing-firmware/nrf52/update-techo-bootloader/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) with v0.6.1 (the UF2 file method doesn't seem to work for me).
2. Erasing the flash of the T-Echo using https://flasher.meshtastic.org.
3. Flashing the new firmware using https://flasher.meshtastic.org.

But then 3 days later, the same thing happens again and the T-Echo becomes nonreactive. Do I have a defective device or are these known issues?

stefanthoss, 2024-08-06:
Same with the latest stable Meshtastic firmware v2.4.0.

wesker-albert, 2024-09-03:
Same situation with the two T-Echo devices I bought straight from Lilygo. Erased, reflashed. Works fine for maybe a few days, then corrupts itself again.

They're pretty much $50 paperweights currently. One was intended to be a mobile solution, but I can't even rely on it enough to take it with me.

InsigneousLeptogre, 2024-10-20:
I've had mine a few weeks and havent had this issue.

KptMorgen, 2024-12-16:
I have the same - bought 2 pc, one works just fine, the other froze just the way you describe. It seems to me from the description it's just the firmware though?

stefanthoss, 2024-12-26:
Closing this ticket. This was a software issue with the public LongFast channel on nRF52 devices, the issue did not occur on my T-Echo when I didn't have the default public channel configured. It seems to be solved in the newer 2.5.10+ versions as I haven't seen it in a while even with the default public channel. I read somewhere on Discord that there was a memory leak in earlier versions which caused the bug when there was a lot of nodes in the local node DB.

Closed 2024-12-26.

Thread 48 (2024-09-06):

How to use GxEPD2 instead of GxDEPG0150BN - Avoiding screen flickering

goedzo, 2024-09-06:
In all the examples GxDEPG0150BN.h is used to display something on the screen. This works partially, because display->updateWindow() makes the screen flicker completely white, even when I only update a small region.

So I want to upgrade to GxEPD2 to avoid flickering and have better control with paging. However I cannot get it to display anything. I use the following code, but not sure why this is not working:

Note that display_v1 is working for the normal GxEPD v1, but the code with display-> does nothing.

```
#include "utilities.h"
#include <stdint.h>
#include "settings.h"
#include "app_modes.h"
#include <GxIO/GxIO_SPI/GxIO_SPI.h>
#include <GxIO/GxIO.h>
#include <GxDEPG0150BN/GxDEPG0150BN.h>  // 1.54" b/w
#include "epd/GxEPD2_150_BN.h"
#include <GxEPD2_BW.h>  // For black and white displays

#include <Fonts/FreeMonoBold9pt7b.h>
#include <Fonts/FreeMonoBold12pt7b.h>

// E-Paper display initialization
SPIClass        *dispPort  = nullptr;
GxIO_Class      *io        = nullptr;
GxEPD_Class     *display_v1   = nullptr;
GxEPD2_BW<GxEPD2_150_BN, GxEPD2_150_BN::HEIGHT>* display = nullptr;

void setupDisplay() {

    //This is v1 of GxD that seems to work
    dispPort = new SPIClass(
        /*SPIPORT*/NRF_SPIM2,
        /*MISO*/ ePaper_Miso,
        /*SCLK*/ePaper_Sclk,
        /*MOSI*/ePaper_Mosi);

    io = new GxIO_Class(
        *dispPort,
        /*CS*/ ePaper_Cs,
        /*DC*/ ePaper_Dc,
        /*RST*/ePaper_Rst);

    display_v1 = new GxEPD_Class(
        *io,
        /*RST*/ ePaper_Rst,
        /*BUSY*/ ePaper_Busy);

    dispPort->begin();
    display_v1->init(/*115200*/);
    display_v1->setRotation(3);
    display_v1->fillScreen(GxEPD_WHITE);
    display_v1->setTextColor(GxEPD_BLACK);
    display_v1->setFont(&FreeMonoBold9pt7b);
    display_v1->update();

    //Now let's see if GxEPD2 works aswell
    display = new GxEPD2_BW<GxEPD2_150_BN, GxEPD2_150_BN::HEIGHT>(GxEPD2_150_BN(ePaper_Cs, ePaper_Dc, ePaper_Rst, ePaper_Busy));
    display->init(115200); // Initialize with baud rate
    display->setRotation(3); // Set display rotation
    display->clearScreen();
    display->setFullWindow(); // Use the full display window
    display->firstPage();     // Start drawing in first page
    do {
        display->fillScreen(GxEPD_WHITE); // Clear the screen
        display->setTextColor(GxEPD_BLACK); // Set text color
        display->setFont(&FreeMonoBold9pt7b); // Set default font
        display->setCursor(0, 100);
        display->print("Hello world!");
    } while (display->nextPage()); // Repeat until all pages are drawn
    display->refresh(false);
    display->display(false);
}
```

goedzo, 2024-09-06:
Here is also a simple helloworld sketch (that you can use completely), which also shows nothing on the screen:

```
#include <GxEPD2_BW.h>
#include <Fonts/FreeMonoBold9pt7b.h>
#include <Wire.h>
#include <SPI.h>

// Define the display class and the display size
#define GxEPD2_DRIVER_CLASS GxEPD2_150_BN
GxEPD2_BW<GxEPD2_DRIVER_CLASS, GxEPD2_150_BN::HEIGHT> display(GxEPD2_150_BN(
  /*CS=*/ 30,  // ePaper_Cs
  /*DC=*/ 28,  // ePaper_Dc
  /*RST=*/ 2,  // ePaper_Rst
  /*BUSY=*/ 3  // ePaper_Busy
));

void setup() {
  // Wait for Serial Monitor to be connected
  Serial.begin(115200);
  while (!Serial) {
    ; // Wait for the serial connection
  }

  Serial.println("Serial initialized...");

  // Start SPI communication and initialize the display
  Serial.println("Initializing display...");
  display.init();
  delay(1000); // Give time for display to initialize
  Serial.println("Display initialized.");

  // Clear the display buffer
  display.setRotation(1); // Rotate display if needed (0-3)
  Serial.println("Display rotation set.");

  display.setTextColor(GxEPD_BLACK);
  Serial.println("Text color set to black.");

  // Print "Hello world" on the screen
  Serial.println("Starting display update...");

  display.firstPage();
  do {
    Serial.println("Clearing the display...");
    display.fillScreen(GxEPD_WHITE); // Clear the display

    Serial.println("Setting font...");
    display.setFont(&FreeMonoBold9pt7b); // Use a built-in font

    Serial.println("Setting cursor position...");
    display.setCursor(10, 40); // Position for the text

    Serial.println("Printing 'Hello world'...");
    display.print("Hello world");
  } while (display.nextPage());

  // Refresh the display after drawing
  Serial.println("Refreshing the display...");
  display.refresh(); // This will ensure the content is rendered on the display

  Serial.println("Display refresh finished.");

  // Add delay to allow e-paper to finish update
  delay(5000);
}

void loop() {
  // Nothing to do here
}

```

goedzo, 2024-09-06:
Ok I seem to have found the solution :).

The init of the display needs to get custom SPI variable in order to work:

```
    // Create SPI settings with speed, data order, and mode
    SPISettings spiSettings(4000000, MSBFIRST, SPI_MODE0);  // 4 MHz speed, MSB first, SPI mode 0

    //Now let's see if GxEPD2 works aswell
    display = new GxEPD2_BW<GxEPD2_150_BN, GxEPD2_150_BN::HEIGHT>(GxEPD2_150_BN(ePaper_Cs, ePaper_Dc, ePaper_Rst, ePaper_Busy));

```

goedzo, 2024-09-06:
And in case you need a full example, here is the working "hello world" code completely

```
#include <GxEPD2_BW.h>
#include <Fonts/FreeMonoBold9pt7b.h>
#include <Wire.h>
#include <SPI.h>

// Declare the display class and custom SPI settings
SPISettings spiSettings(4000000, MSBFIRST, SPI_MODE0);  // 4 MHz speed, MSB first, SPI mode 0
GxEPD2_BW<GxEPD2_150_BN, GxEPD2_150_BN::HEIGHT>* display; // Pointer for dynamic allocation
SPIClass* dispPort;

// Pin definitions for the e-paper display
const int ePaper_Miso = 6;  // Define these based on your hardware setup
const int ePaper_Mosi = 29;
const int ePaper_Sclk = 31;
const int ePaper_Cs = 30;
const int ePaper_Dc = 28;
const int ePaper_Rst = 2;
const int ePaper_Busy = 3;

void setup() {
  // Start Serial Monitor
  Serial.begin(115200);
  while (!Serial) {
    ; // Wait for serial to be ready
  }

  Serial.println("Serial initialized...");

  // Create a new SPIClass instance for the e-paper display
  dispPort = new SPIClass(NRF_SPIM2, ePaper_Miso, ePaper_Sclk, ePaper_Mosi);

  // Initialize the SPI port
  dispPort->begin();

  // Dynamically allocate memory for the GxEPD2 display object
  display = new GxEPD2_BW<GxEPD2_150_BN, GxEPD2_150_BN::HEIGHT>(GxEPD2_150_BN(ePaper_Cs, ePaper_Dc, ePaper_Rst, ePaper_Busy));

  // Initialize the display with custom SPI class and settings
  display->init(115200, true, 20, false, *dispPort, spiSettings);
  Serial.println("Display initialized with custom SPI.");

  // Set display rotation, fill screen, and set text properties
  display->setRotation(3);
  display->fillScreen(GxEPD_WHITE);
  display->setTextColor(GxEPD_BLACK);
  display->setFont(&FreeMonoBold9pt7b);

  // Draw "Hello World" on the display
  display->firstPage();
  do {
    display->setCursor(10, 40);
    display->print("Hello world!");
  } while (display->nextPage());

  // Refresh the display to show the content
  display->refresh();

  Serial.println("Display update complete.");
}

void loop() {
  // Nothing to do here
}

```

Closed 2024-09-06.

Thread 49 (2024-09-12):

README.MD Arduino IDE installation instructions reference non-existing

Abdull, 2024-09-12:
For setting up the LilyGO T-Echo in Arduino IDE, [the `README.MD` mentions to select *Adafruit nRF52* board ***Nordic nRF52840(PCA10056)***](https://github.com/Xinyuan-LilyGO/T-Echo/blame/537b5233f01365d60d18e64964fa3a7306ea769a/README.MD#L13), but this board does not exist (anymore?) in boards manager *Adafruit nRF52 by Adafruit, version 1.6.1*.

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

Which board shall be selected instead? Please update the README.MD.

lyusupov, 2024-09-13:
> Which board shall be selected instead?

**Nordic nRF52840 DK**

<br>
<br>

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

<br>
<br>

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

Closed 2025-04-08.

Thread 50 (2024-09-24):

Bluetooth connect to HID keyboard example fails

goedzo, 2024-09-24:
I am trying to connect a bluetooth HID keyboard to my t-echo, however the example code https://github.com/Xinyuan-LilyGO/T-Echo/tree/main/examples/ble_hid_central does not work.

Even the comment in the code itself says this:
```    display->print("Scan ble keyboard"); //crashes here

So how can I connect my bluetooth keyboard to my t-echo device?

Thread 52 (2024-11-24):

battery conversions help

richonguzman, 2024-11-24:
sample = analogRead(BATTERY_PIN);

voltage = sample * batteryConversion;

what are the conversions value to get real voltage / battery data?

lyusupov, 2024-11-28:
https://github.com/Xinyuan-LilyGO/T-Echo/blob/main/T-Echo_Schematic.pdf

richonguzman, 2024-11-30:
> https://github.com/Xinyuan-LilyGO/T-Echo/blob/main/T-Echo_Schematic.pdf

that was I missing!

thanks!

Closed 2024-11-30.

Thread 53 (2025-01-21):

Broken Reset Button

joe-albanese, 2025-01-21:
Hello. I've dropped my T-Echo and broke my reset button. How can I purchase a replacement button?

Closed 2025-01-23.

Thread 54 (2025-03-04):

Critical fault #12

shawndearmond, 2025-03-04:
I have been using the T-Echo for months, but it is now stuck with the screen displaying "Critical fault #12". When I plug it in to a computer or power, the lights do not come on. I have tried every combination of pressing and holding the buttons. The screen won't refresh, and I can't get it to mount on my computer.

I've only had this since November.

lewisxhe, 2025-07-16:
Have you flashed other firmware before?

Now double-click the upper left button and the disk device cannot be ejected?

Closed 2025-07-16.

Thread 55 (2025-03-11):

Reset button not functioning as it should once battery has gone flat and it's been recharged

parahooners, 2025-03-11:
Why does the board get stuck after the battery goes flat ? What causes this problem when after charging the board does not come back on unless it's plugged back into the PC and the serial line tool is used?

I'd like to use the board as a gps tool but it's a faf having to pull the battery every time I want the board to start back up...

Thread 57 (2025-04-25):

I seem to have bricked my T-Echo

ketan, 2025-04-25:
Hi,

I seem to have bricked my t-echo. It no longer shows up as a USB drive when double-clicking the reset button. I've tried removing the battery etc. Is there a way to re-upload the bootloader and reflash?

I use macos sequoia (m4), if that makes any difference.

Thanks

lewisxhe, 2025-07-14:
Can you tell me what you did?
As long as no other program is written through the SWD interface, the boot is always there.

Vaanhool, 2025-07-24:
I have the same problem with two T-Echo devices. They are unusable for almost one year. If I remember correctly I uploaded new SoftRF firmware via DFU mode then all of them bricked. Doesn't respond to anything, no DFU mode. The red LED is constantly on, the blue LED is flashes once when I plug the USB C cable then a pause of about 12 seconds and after thet is it flashes a short every second.
It wasn't the first update, I hadn't experienced anything like this before.

I tried burn bootloader with Arduino IDE, but the board not responding or not in DFU mode and failure.

lewisxhe, 2025-07-25:
Double-click the upper left button. If you cannot enter DFU mode, there may be two reasons:
1. The motherboard is dead
2. Burning other firmware has damaged the boot program

You can only re-burn the boot firmware to see if the boot program can be written into t-echo normally.

The swd interface of t-echo is next to the usb. You need a jlink or daplink

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

ketan, 2025-07-25:
Thanks for the pinout. I'll take a stab at re-programming this.

Vaanhool, 2025-08-15:
I have had success with both T-echoes. I followed this tutorial:

[https://github.com/Xinyuan-LilyGO/T-Echo/blob/main/bootloader/README.MD](url)

Some advices:
- disconnect the batteries before flashing.
- you need 4 dupont female wire or this if you don't want remove the board from the case to solder a header for connection [https://www.aliexpress.com/item/1005009672504212.html](url)
- power the device with USB C cable
- erase the flash first, after that burn the bootloader

I ordered many SWD interface before that but only this one worked with the J-Flash (Lite).
[https://www.aliexpress.com/item/1005007350851129.html](url)

My problem was that I saved the SoftRf firmware with a right click and instead of binary code it was saved with html content. I overlooked this and copied it to the device, after that the DFU mode disappeared.

Thanks

Vaanhool, 2025-08-21:
> [@Vaanhool](https://github.com/Vaanhool) - what firmware.hex file did you flash — the bootloader, or softrf itself?

Hi,
I used the 0.6.1 adatfruit bootloader from this:
[https://github.com/lyusupov/SoftRF/tree/master/software/firmware/binaries/nRF52840/Adafruit_nRF52_Bootloader](url)

After that, you can put the device to DFU mode and copy the proper uf2 file to the UDisk.

Thread 60 (2025-08-12):

Damaged board with overvoltage, repair attempt

rmu75, 2025-08-12:
Faulty USB brick and/or moisture in the enclosure somehow damaged my T-Echo. The LDO, the nrf SOC and some FETs near the USB connector let the smoke out.

I found the schematics, got replacement parts and fixed things that looked broken (Q6, Q7, Q8, U11, also replaced U9 and D7 just to be sure) and somewhat successfully even replaced the SOC.

Now the 3v3 rail is stable, board draws about 140mA on 5V, and I could flash the bootloader via SWD while being powered via USB-C. But now I'm stuck -- the board won't enumerate on USB-C, and it doesn't respond anymore on SWD while powered via USB-C.

Powering via SWD with 3,3V, i can connect with openocd, halt target, look around, investigate flash etc..., all seems normal. Running the SOC from openocd causes pulsing red LED.

Investigating a bit further, something seems wrong with the power supply VDD_nRF, powering via USB, that rail only goes up to 1,8V. According to schematics, this should be connected to VDD3V3 (which measures OK at 3,3V and seems to be stable when looking on the scope) via L8. Because of incomplete silksreen, I'm not sure where to look exactly for L8, continuity-testing only got me to some unpopulated footprint next to the crystal cluster near the LORA module.

So I'm stuck. Any help or hint would be greatly appreciated -- maybe the PCB artwork is available somewhere or at least identification which parts are placed where and if there are parts that are not populated. Thanks.

lewisxhe, 2025-08-13:
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

This should help you

rmu75, 2025-08-13:
> [T-Echo.pdf](https://github.com/user-attachments/files/21745700/T-Echo.pdf)
>
> This should help you

Thank you very much, exactly what I was looking for, that is indeed very helpful.

Closed 2025-08-13.
