Xinyuan-LilyGO/T-Echo/schematic/T-ECHO-CON V1.0 25-02-20.pdf

D

6 | 5 | 4 | 3 | 2 | 1

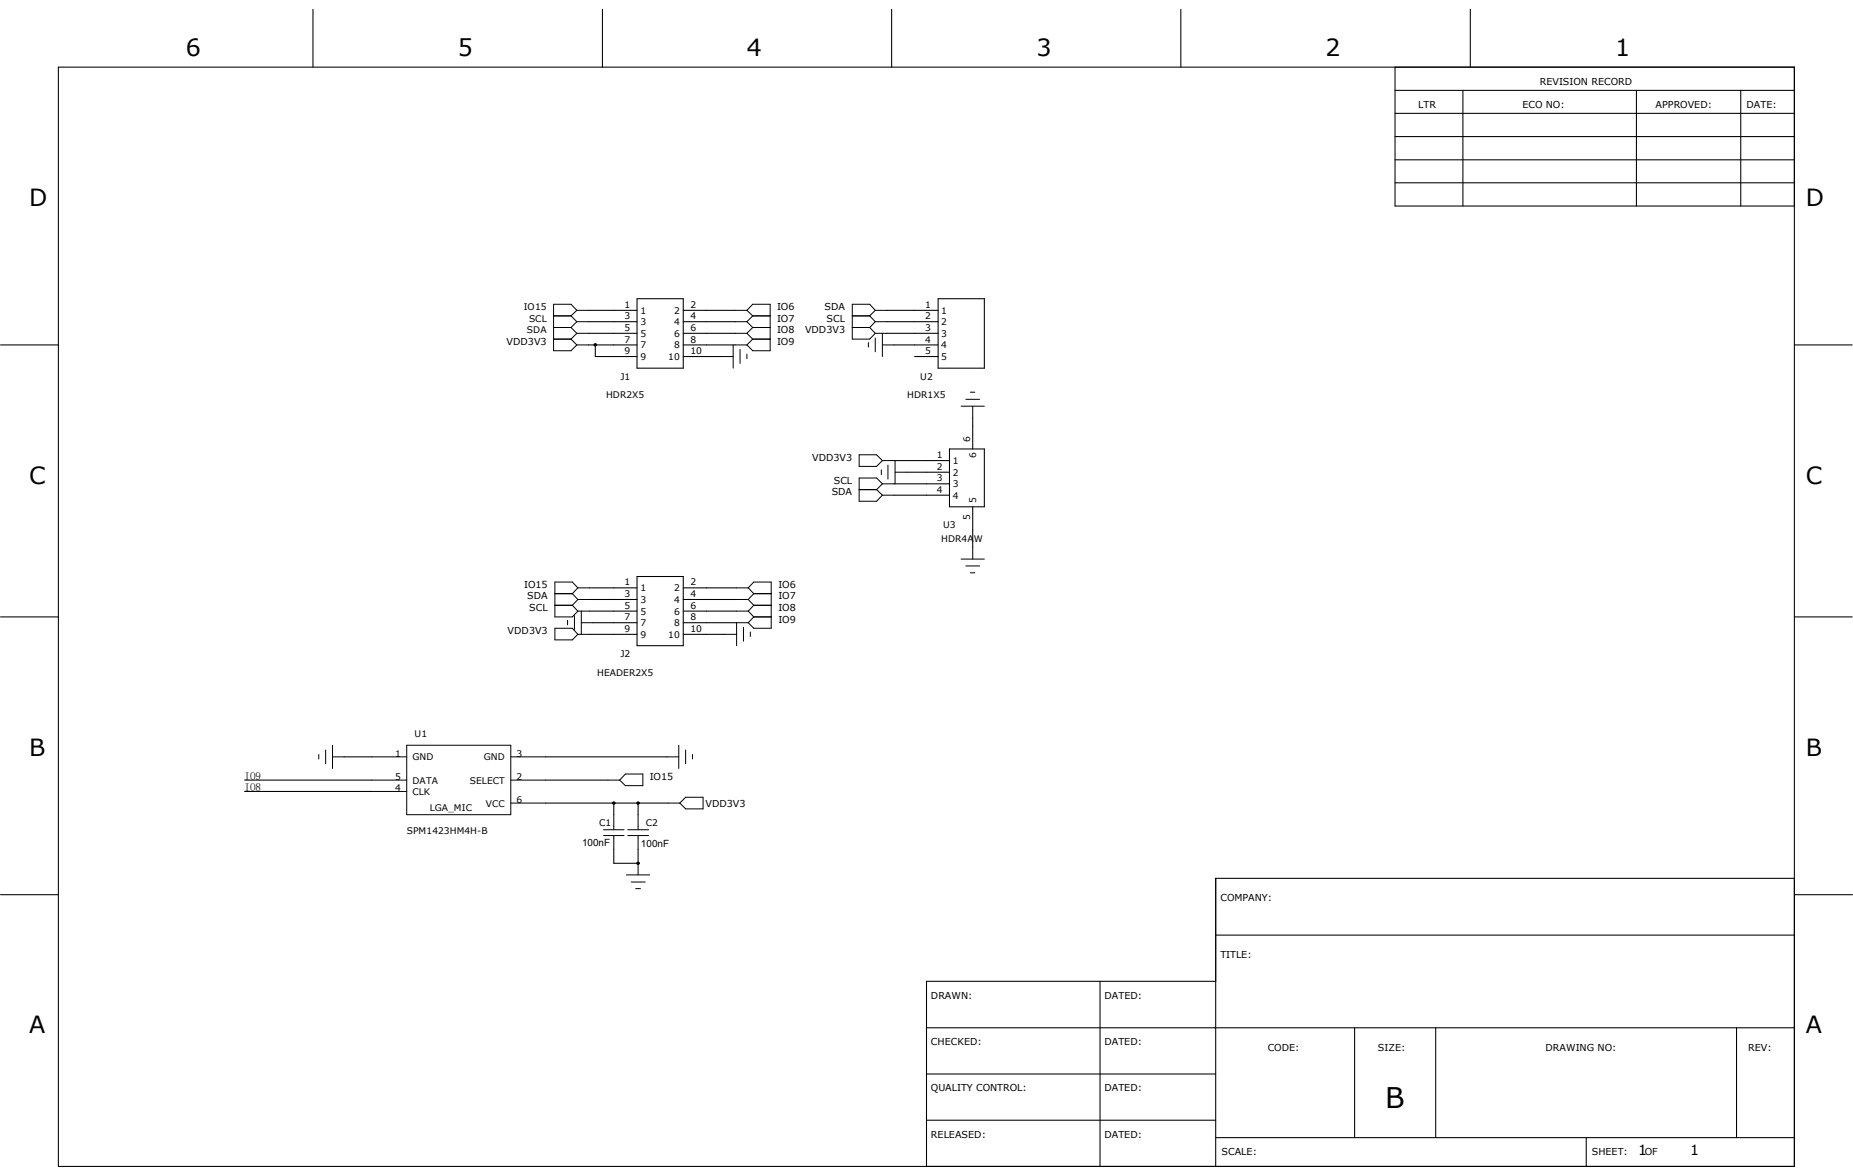
[picture p36: page 1]
COMPANY:; TITLE:; HDR2X5; HDR1X5; U3 HDR4AW; HEADER2X5; 1 GND; 2 SELECT; GND; 4 CLK; 5 DATA; 6 VCC; LGA_MIC; SPM1423HM4H-B; IO15 SCL SDA VDD3V3; VDD3V3; SCL SDA; SDA SCL VDD3V3; IO15 SDA SCL

REVISION RECORD

LTR | ECO NO: | APPROVED: | DATE:

9 | 10 10

DRAWN: | DATED:
CHECKED: | DATED: | CODE: | SIZE: B | DRAWING NO: | REV:

QUALITY CONTROL: | DATED:

RELEASED: | DATED:

SCALE: | 1 1 SHEET: OF
