Xinyuan-LilyGO/T-Echo/schematic/T-ECHO-A7682.pdf

# LED

通讯

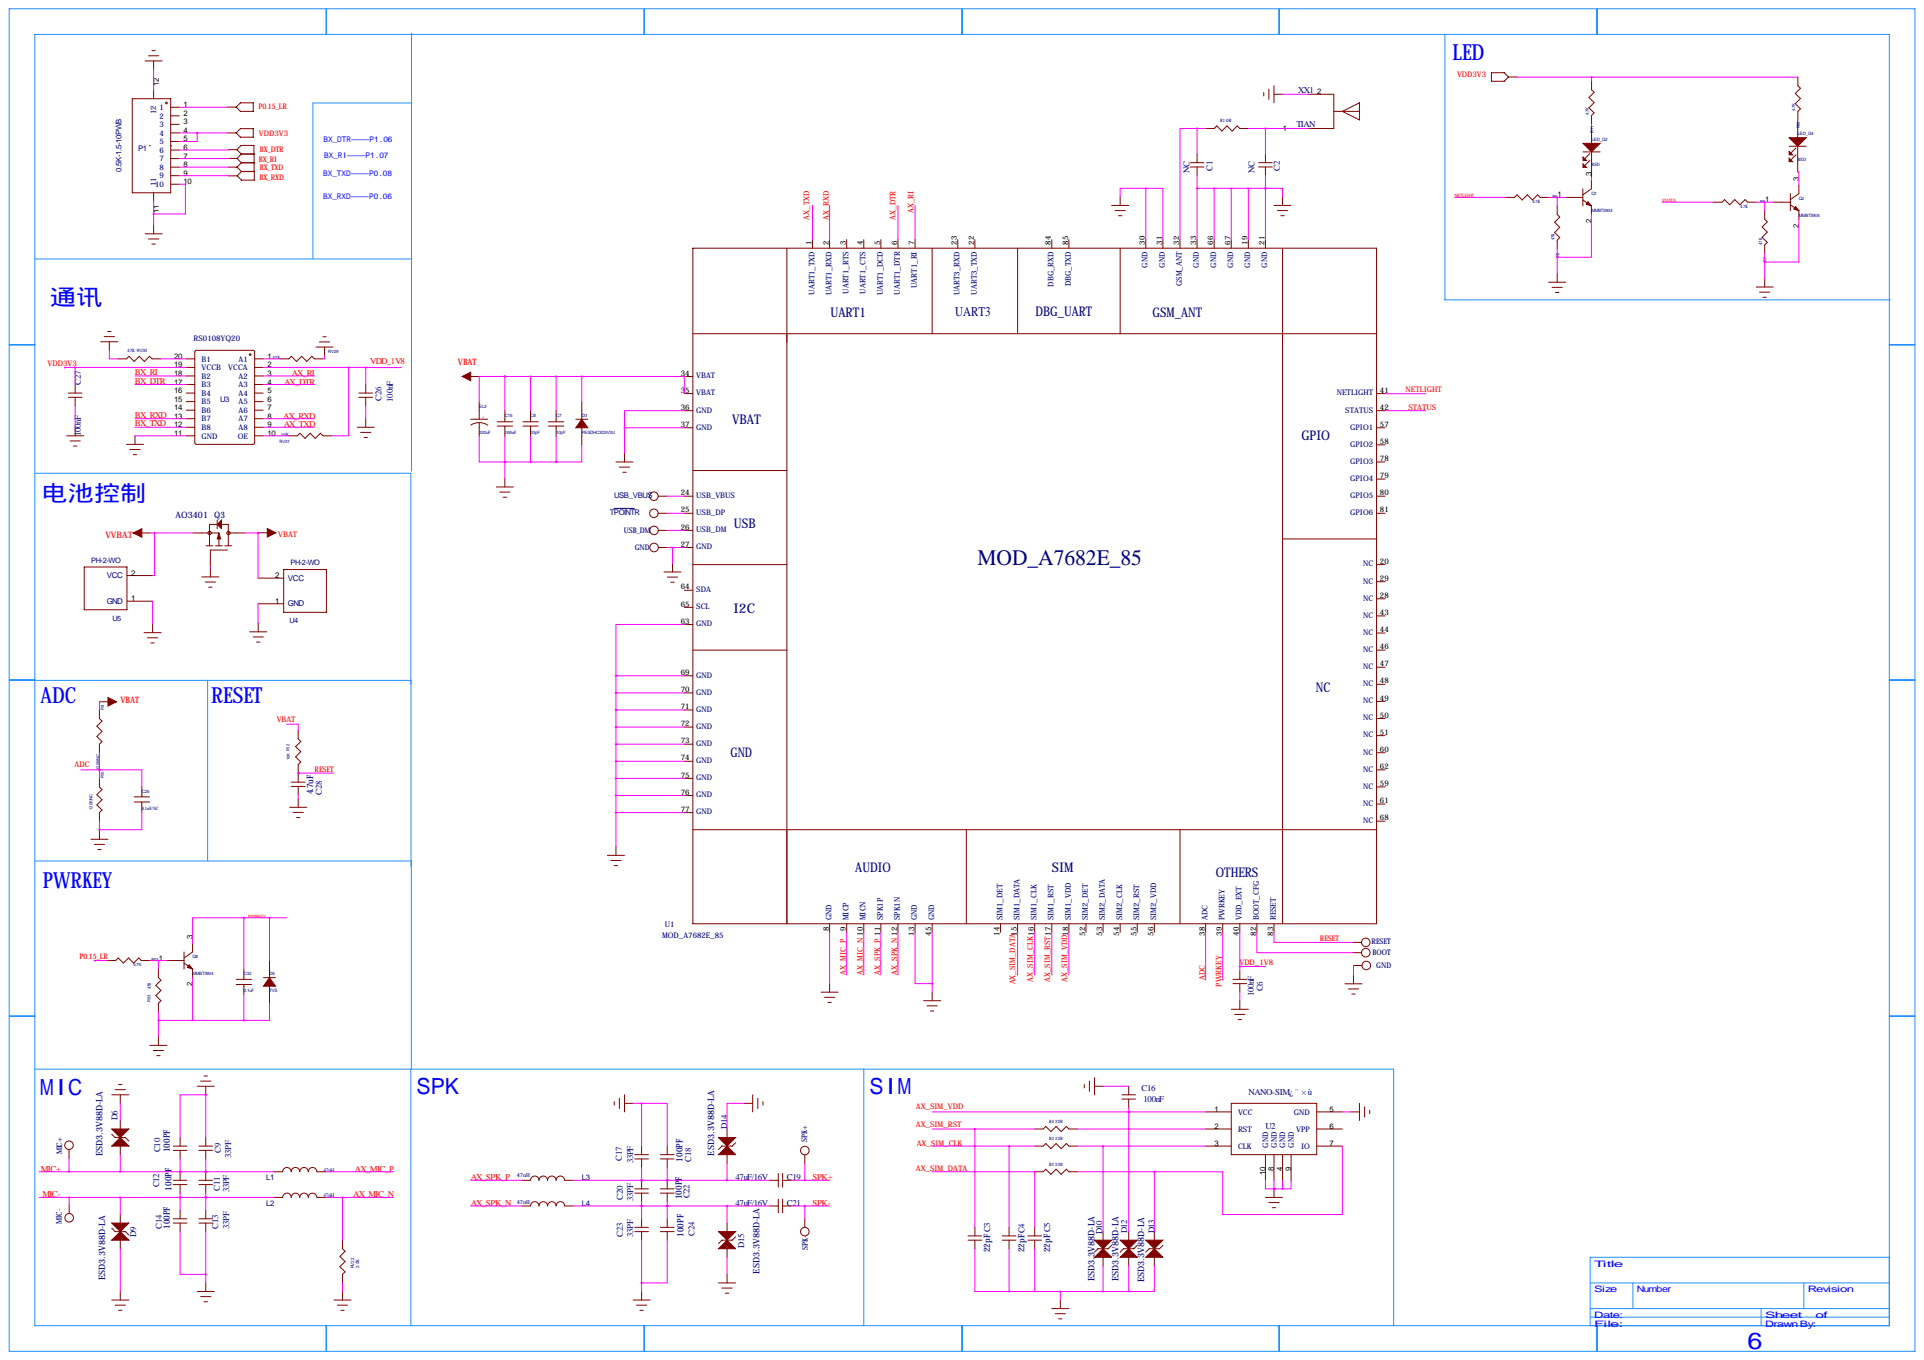
[picture p37: page 1]

UART1 | UART3 | DBG_UART | GSM_ANT

VBAT | | | | | GPIO | 41 NETLIGHT 42 STATUS 57 GPIO1 58 GPIO2 78 GPIO3 79 GPIO4 80 GPIO5 81 GPIO6

MIC+ 47nH AX_MIC_P MIC-AX_MIC_N 47nH

Size | Number | Revision

Date: | Sheet of
File: | Drawn By:
