Xinyuan-LilyGO/T-Echo/schematic/T-Echo_Schematic.pdf

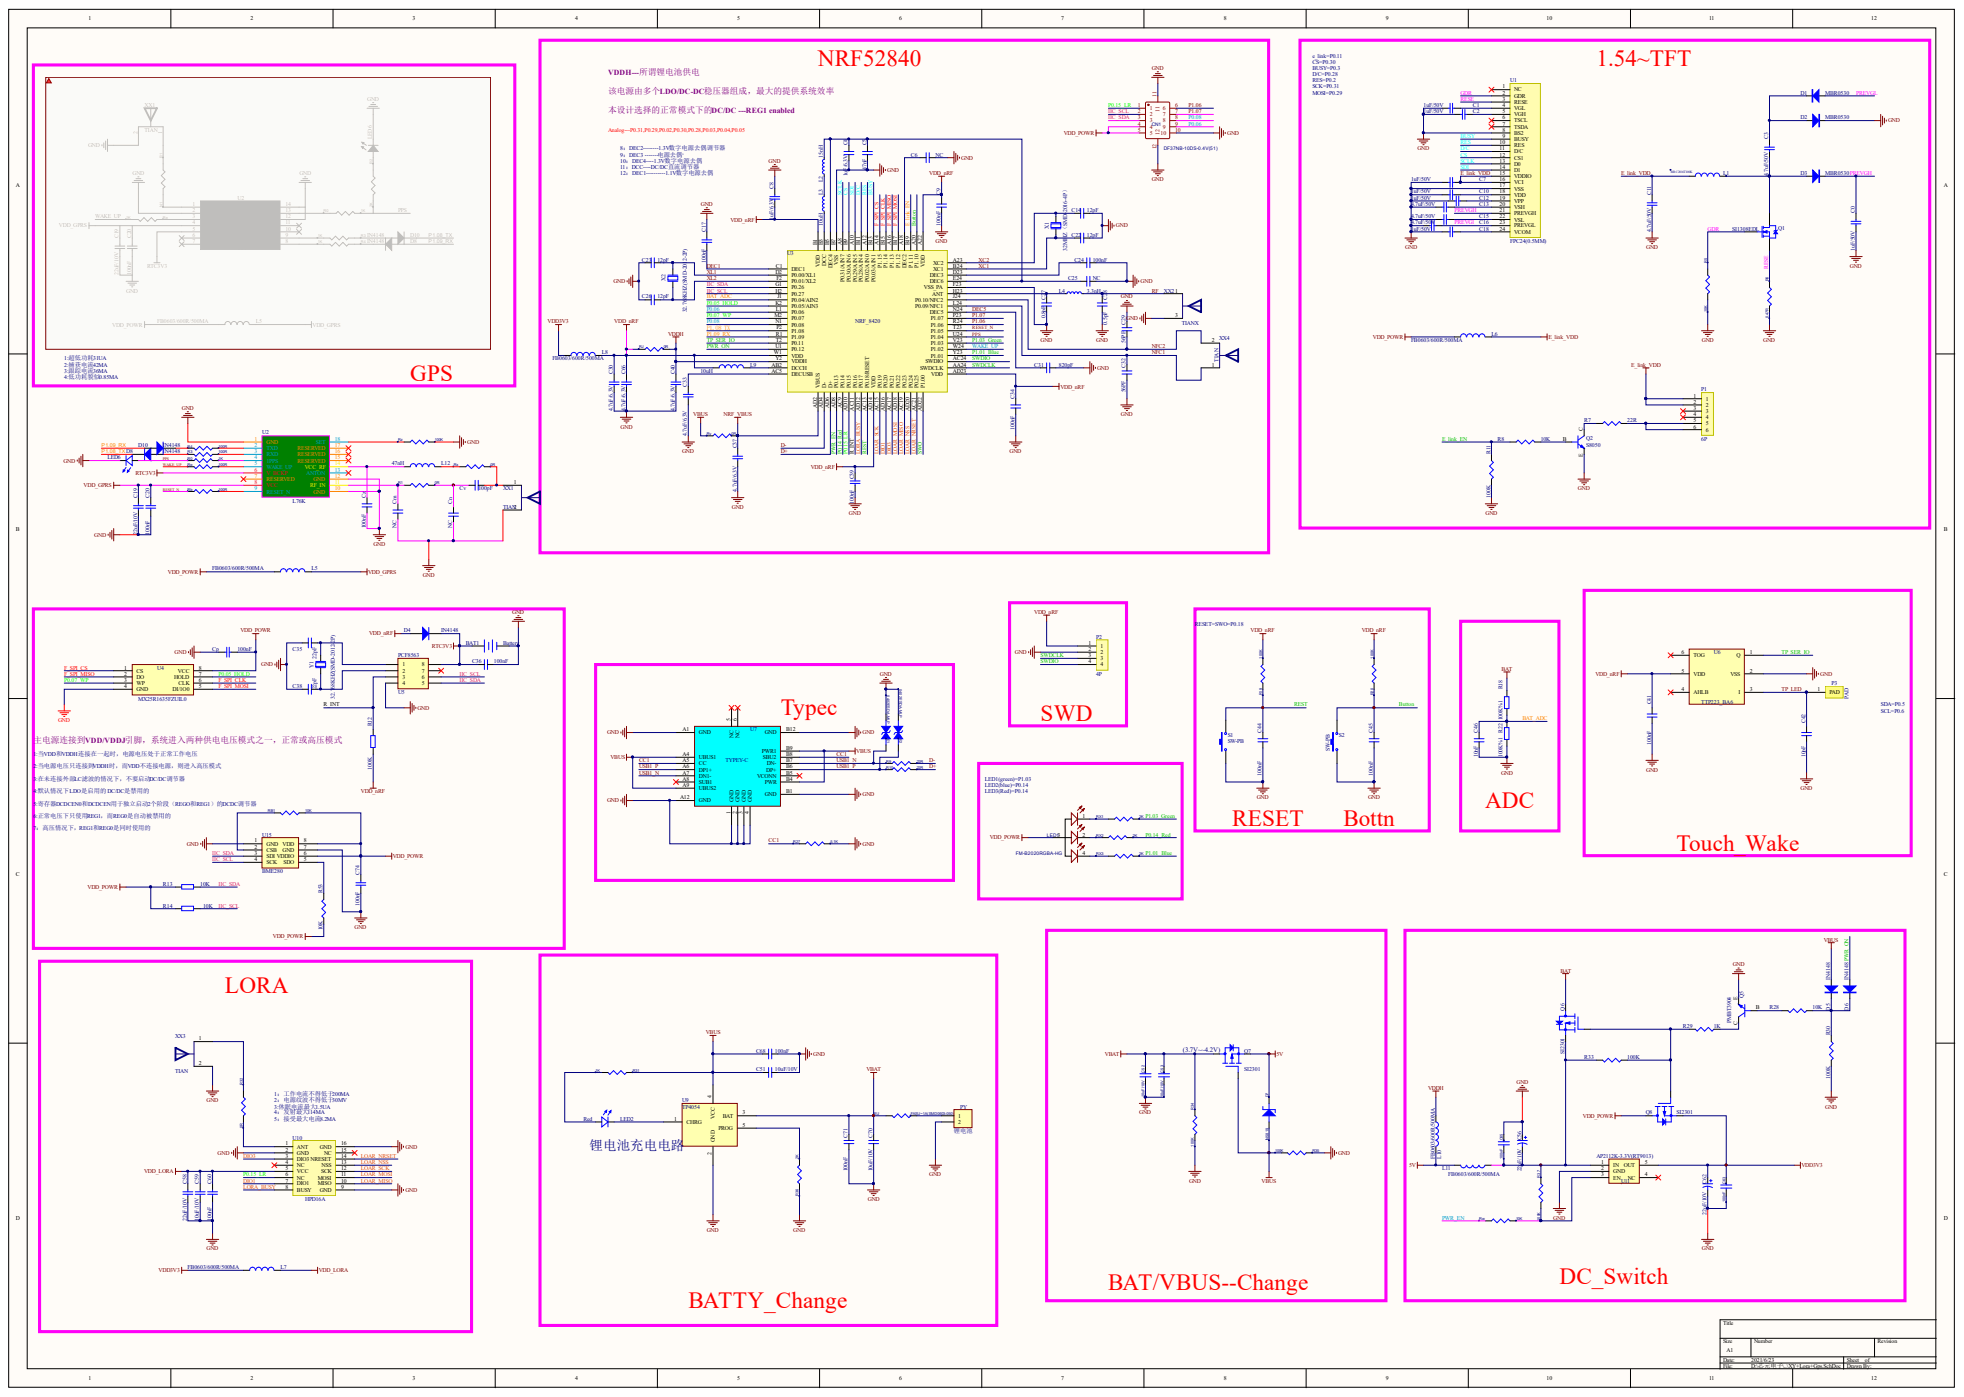
[picture p38: page 1]

该电源由多个LDO/DC-DC稳压器组成，最大的提供系统效率

DEC1 XL1 | P0.00/XL1 D2 | XC1

VDDH Y2 | SWDIO

10uH | L9 | DCCH AB2 DECUSB AC5 | SWDCLK

RESET_N Rb 100R | VCC 8

主电源连接到VDD/VDDJ引脚，系统进入两种供电电压模式之一，正常或高压模式

IIC_SDA | GND 1 CSB 2
