Xinyuan-LilyGO/T-Echo/schematic/T-BHI260.pdf

# SCL_1V8 VDD¹V8 VDD³V3 VDD¹V8

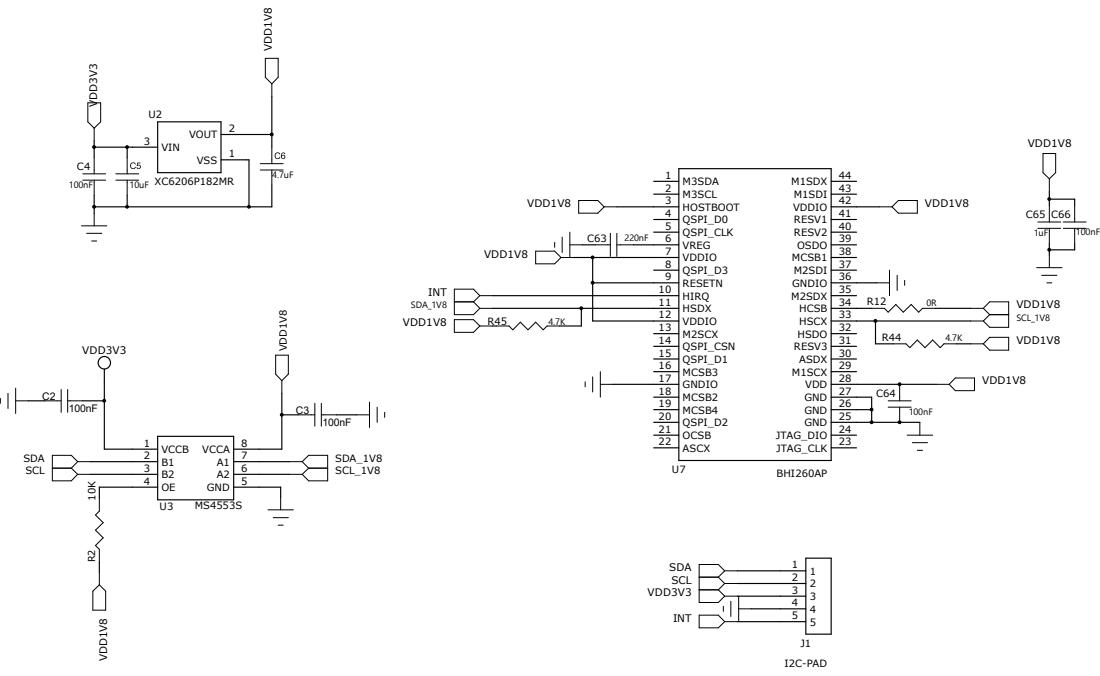
[picture p39: page 1]
