Xinyuan-LilyGO/T-Echo/schematic/T-BHI260_V1.1.pdf

# SCL_1V8 VDD¹V8 VDD³V3 VDD¹V8

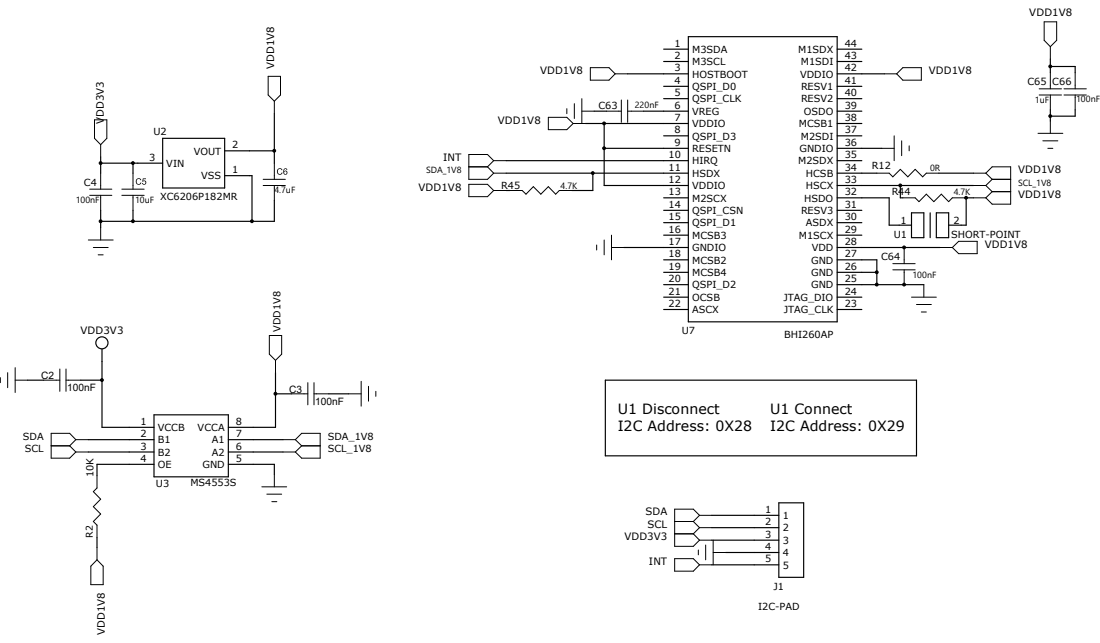
[picture p40: page 1]
