Xinyuan-LilyGO/T-Echo/schematic/T-ICM29048.pdf

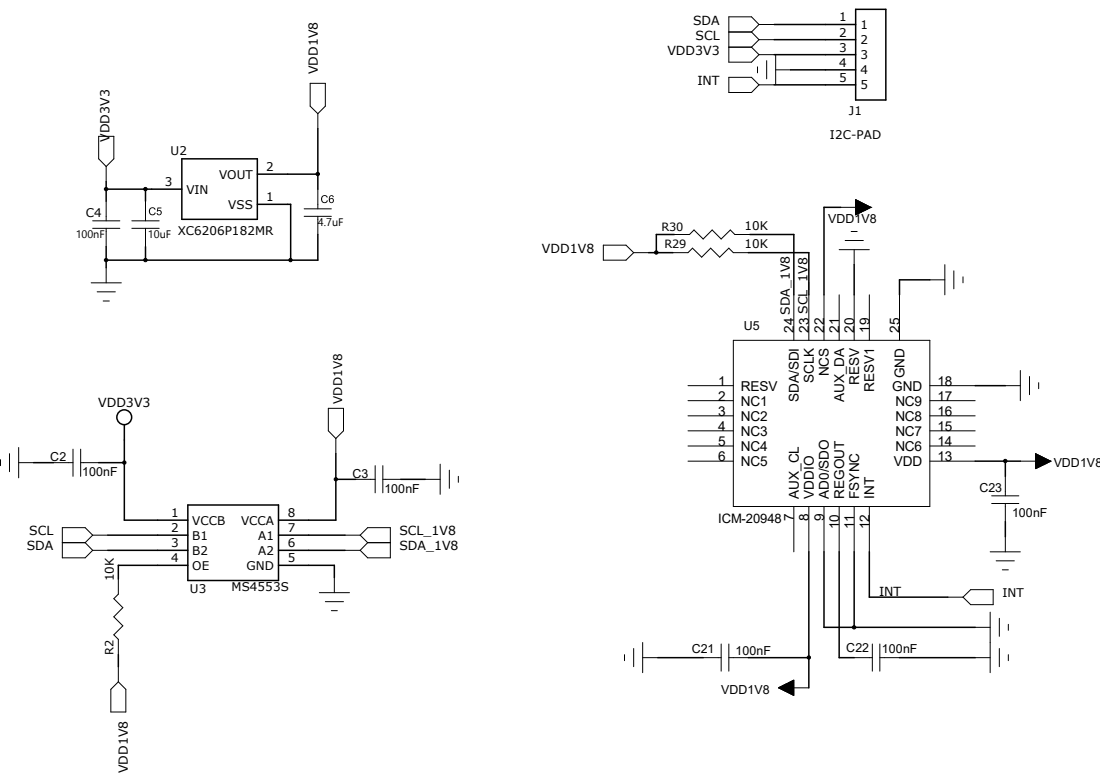
[picture p41: page 1]
