Xinyuan-LilyGO/T-Echo/examples/A7682/MqttClient/MqttClient.ino

#define TINY_GSM_MODEM_SIM7600 //A7682 Compatible with SIM7600 AT instructions
#define TINY_GSM_RX_BUFFER 1024 // Set RX buffer to 1Kb
#define SerialAT Serial1
#define TINY_GSM_DEBUG Serial
// See all AT commands, if wanted
// #define DUMP_AT_COMMANDS

#define TINY_GSM_USE_GPRS true

// set GSM PIN, if any
#define GSM_PIN ""

// Your GPRS credentials, if any
const char apn[]      = "YourAPN";
// const char apn[]      = "CMNET";
const char gprsUser[] = "";
const char gprsPass[] = "";

// MQTT details
const char *broker = "broker.hivemq.com";

const char *topicLed       = "GsmClientTest/led";
const char *topicInit      = "GsmClientTest/init";
const char *topicLedStatus = "GsmClientTest/ledStatus";

#define UART_BAUD   115200

#include "utilities.h"
#include <SPI.h>
#include <Wire.h>

#include <GxEPD.h>
#include <GxDEPG0150BN/GxDEPG0150BN.h>  // 1.54" b/w 

#include GxEPD_BitmapExamples
#include <Fonts/FreeMonoBold12pt7b.h>
#include <GxIO/GxIO_SPI/GxIO_SPI.h>
#include <GxIO/GxIO.h>
#include <TinyGsmClient.h>
#include <PubSubClient.h>
#include <Adafruit_TinyUSB.h> // for Serial



#ifdef DUMP_AT_COMMANDS  // if enabled it requires the streamDebugger lib
#include <StreamDebugger.h>
StreamDebugger debugger(SerialAT, SerialMon);
TinyGsm modem(debugger);
#else
TinyGsm modem(SerialAT);
#endif


TinyGsmClient client(modem, 0);
PubSubClient  mqtt(client);

bool reply = false;
void setupDisplay();
void enableBacklight();
void configVDD(void);
void boardInit();
void LilyGo_logo(void);

SPIClass        *dispPort  = nullptr;
SPIClass        *rfPort    = nullptr;
GxIO_Class      *io        = nullptr;
GxEPD_Class     *display   = nullptr;

uint32_t        blinkMillis = 0;
uint8_t rgb = 0;



int ledStatus = LOW;

uint32_t lastReconnectAttempt = 0;

void mqttCallback(char *topic, byte *payload, unsigned int len)
{

    SerialMon.print("Message arrived [");
    SerialMon.print(topic);
    SerialMon.print("]: ");
    SerialMon.write(payload, len);
    SerialMon.println();

    // Only proceed if incoming message's topic matches
    if (String(topic) == topicLed) {
        ledStatus = !ledStatus;
        // digitalWrite(LED_PIN, ledStatus);
        SerialMon.print("ledStatus:");
        SerialMon.println(ledStatus);
        mqtt.publish(topicLedStatus, ledStatus ? "1" : "0");

    }
}

boolean mqttConnect()
{
    SerialMon.print("Connecting to ");
    SerialMon.print(broker);

    // Connect to MQTT Broker
    boolean status = mqtt.connect("GsmClientTest");

    // Or, if you want to authenticate MQTT:
    // boolean status = mqtt.connect("GsmClientName", "mqtt_user", "mqtt_pass");

    if (status == false) {
        SerialMon.println(" fail");
        return false;
    }
    SerialMon.println(" success");
    mqtt.publish(topicInit, "GsmClientTest started");
    mqtt.subscribe(topicLed);
    return mqtt.connected();
}



void setup()
{
    Serial.begin(115200);




    pinMode(A7682_PWR, OUTPUT);
    // A7682  Power off
    digitalWrite(A7682_PWR, HIGH);
    delay(4000);
    digitalWrite(A7682_PWR, LOW);
    delay(4000);

    // A7682  Power on
    digitalWrite(A7682_PWR, LOW);
    delay(100);
    digitalWrite(A7682_PWR, HIGH);
    delay(1000);
    digitalWrite(A7682_PWR, LOW);
    delay(500);
    pinMode(A7682_RI, INPUT_PULLUP);
    pinMode(A7682_DTR, OUTPUT);
    digitalWrite(A7682_DTR, LOW);

    delay(200);
    boardInit();
    delay(200);
    LilyGo_logo();

    SerialAT.setPins(A7682_TXD, A7682_RXD);
    SerialAT.begin(115200, SERIAL_8N1);


    int i = 10;
    Serial.println("\nTesting Modem Response...\n");
    Serial.println("****");
    while (i) {
        SerialAT.println("AT");
        delay(500);
        if (SerialAT.available()) {
            String r = SerialAT.readString();
            SerialAT.println(r);
            if ( r.indexOf("OK") >= 0 ) {
                reply = true;
                break;;
            }
        }
        delay(500);
        i--;
    }
    Serial.println("****\n");

    if (reply) {
        Serial.println(F("***********************************************************"));
        Serial.println(F(" You can now send AT commands"));
        Serial.println(F(" Enter \"AT\" (without quotes), and you should see \"OK\""));
        Serial.println(F(" If it doesn't work, select \"Both NL & CR\" in Serial Monitor"));
        Serial.println(F(" DISCLAIMER: Entering AT commands without knowing what they do"));
        Serial.println(F(" can have undesired consiquinces..."));
        Serial.println(F("***********************************************************\n"));
    } else {
        Serial.println(F("***********************************************************"));
        Serial.println(F(" Failed to connect to the modem! Check the baud and try again."));
        Serial.println(F("***********************************************************\n"));
    }

    display->setFont(&FreeMonoBold12pt7b);
    display->fillScreen(GxEPD_WHITE);
    display->update();

// Restart takes quite some time
// To skip it, call init() instead of restart()
    SerialMon.println("Initializing modem...");
    if (!modem.init()) {
        SerialMon.println("Failed to restart modem, attempting to continue without restarting");
    }

    String name = modem.getModemName();
    delay(500);
    SerialMon.println("Modem Name: " + name);

    String modemInfo = modem.getModemInfo();
    delay(500);



    modem.gprsConnect(apn, gprsUser, gprsPass);

    delay(500);
    DBG("Waiting for network...");
    if (!modem.waitForNetwork()) {
        delay(10000);
        return;
    }

    if (modem.isNetworkConnected()) {
        DBG("Network connected");
    }

    // GPRS connection parameters are usually set after network registration
    SerialMon.print(F("Connecting to "));
    SerialMon.print(apn);
    if (!modem.gprsConnect(apn, gprsUser, gprsPass)) {
        SerialMon.println(" fail");
        delay(10000);
        return;
    }
    SerialMon.println(" success");

    if (modem.isGprsConnected()) {
        SerialMon.println("GPRS connected");
    }


    // MQTT Broker setup
    mqtt.setServer(broker, 1883);
    mqtt.setCallback(mqttCallback);

}

void loop()
{
    // while (1) {
    //     while (Serial.available()) {
    //         SerialAT.write(Serial.read());
    //     }
    //     while (SerialAT.available()) {
    //         Serial.write(SerialAT.read());
    //     }
    // }


    // Make sure we're still registered on the network
    if (!modem.isNetworkConnected()) {
        SerialMon.println("Network disconnected");
        if (!modem.waitForNetwork(180000L, true)) {
            SerialMon.println(" fail");
            delay(10000);
            return;
        }
        if (modem.isNetworkConnected()) {
            SerialMon.println("Network re-connected");
        }

#if TINY_GSM_USE_GPRS
        // and make sure GPRS/EPS is still connected
        if (!modem.isGprsConnected()) {
            SerialMon.println("GPRS disconnected!");
            SerialMon.print(F("Connecting to "));
            SerialMon.print(apn);
            if (!modem.gprsConnect(apn, gprsUser, gprsPass)) {
                SerialMon.println(" fail");
                delay(10000);
                return;
            }
            if (modem.isGprsConnected()) {
                SerialMon.println("GPRS reconnected");
            }
        }
#endif
    }

    if (!mqtt.connected()) {
        SerialMon.println("=== MQTT NOT CONNECTED ===");
        // Reconnect every 10 seconds
        uint32_t t = millis();
        if (t - lastReconnectAttempt > 10000L) {
            lastReconnectAttempt = t;
            if (mqttConnect()) {
                lastReconnectAttempt = 0;
            }
        }
        delay(100);
        return;
    }

    mqtt.loop();



    if (millis() - blinkMillis > 1000) {
        blinkMillis = millis();
        switch (rgb) {
        case 0:
            digitalWrite(GreenLed_Pin, LOW);
            digitalWrite(RedLed_Pin, HIGH);
            digitalWrite(BlueLed_Pin, HIGH);
            break;
        case 1:
            digitalWrite(GreenLed_Pin, HIGH);
            digitalWrite(RedLed_Pin, LOW);
            digitalWrite(BlueLed_Pin, HIGH);
            break;
        case 2:
            digitalWrite(GreenLed_Pin, HIGH);
            digitalWrite(RedLed_Pin, HIGH);
            digitalWrite(BlueLed_Pin, LOW);
            break;
        default :
            break;
        }
        rgb++;
        rgb %= 3;
    }
}


void LilyGo_logo(void)
{

    display->fillScreen(GxEPD_WHITE);
    display->drawExampleBitmap(BitmapExample1, 0, 0, GxEPD_WIDTH, GxEPD_HEIGHT, GxEPD_BLACK);
    display->update();
}

void enableBacklight(bool en)
{
    digitalWrite(ePaper_Backlight, en);
}

void setupDisplay()
{
    dispPort = new SPIClass(
        /*SPIPORT*/NRF_SPIM2,
        /*MISO*/ ePaper_Miso,
        /*SCLK*/ePaper_Sclk,
        /*MOSI*/ePaper_Mosi);

    io = new GxIO_Class(
        *dispPort,
        /*CS*/ ePaper_Cs,
        /*DC*/ ePaper_Dc,
        /*RST*/ePaper_Rst);

    display = new GxEPD_Class(
        *io,
        /*RST*/ ePaper_Rst,
        /*BUSY*/ ePaper_Busy);

    dispPort->begin();
    display->init(/*115200*/);
    display->setRotation(2);
    display->fillScreen(GxEPD_WHITE);
    display->setTextColor(GxEPD_BLACK);
    display->setFont(&FreeMonoBold12pt7b);
}


void configVDD(void)
{
    // Configure UICR_REGOUT0 register only if it is set to default value.
    if ((NRF_UICR->REGOUT0 & UICR_REGOUT0_VOUT_Msk) ==
            (UICR_REGOUT0_VOUT_DEFAULT << UICR_REGOUT0_VOUT_Pos)) {
        NRF_NVMC->CONFIG = NVMC_CONFIG_WEN_Wen;
        while (NRF_NVMC->READY == NVMC_READY_READY_Busy) {}

        NRF_UICR->REGOUT0 = (NRF_UICR->REGOUT0 & ~((uint32_t)UICR_REGOUT0_VOUT_Msk)) |
                            (UICR_REGOUT0_VOUT_3V3 << UICR_REGOUT0_VOUT_Pos);

        NRF_NVMC->CONFIG = NVMC_CONFIG_WEN_Ren;
        while (NRF_NVMC->READY == NVMC_READY_READY_Busy) {}

        // System reset is needed to update UICR registers.
        NVIC_SystemReset();
    }
}

void boardInit()
{

    uint8_t rlst = 0;

#ifdef HIGH_VOLTAGE
    configVDD();
#endif

    SerialMon.begin(MONITOR_SPEED);
    // delay(5000);
    // while (!SerialMon);
    SerialMon.println("Start\n");

    uint32_t reset_reason;
    sd_power_reset_reason_get(&reset_reason);
    SerialMon.print("sd_power_reset_reason_get:");
    SerialMon.println(reset_reason, HEX);

    pinMode(Power_Enable_Pin, OUTPUT);
    digitalWrite(Power_Enable_Pin, HIGH);

    pinMode(ePaper_Backlight, OUTPUT);
    //enableBacklight(true); //ON backlight
    enableBacklight(false); //OFF  backlight

    pinMode(GreenLed_Pin, OUTPUT);
    pinMode(RedLed_Pin, OUTPUT);
    pinMode(BlueLed_Pin, OUTPUT);

    pinMode(UserButton_Pin, INPUT_PULLUP);
    pinMode(Touch_Pin, INPUT_PULLUP);

    int i = 10;
    while (i--) {
        digitalWrite(GreenLed_Pin, !digitalRead(GreenLed_Pin));
        digitalWrite(RedLed_Pin, !digitalRead(RedLed_Pin));
        digitalWrite(BlueLed_Pin, !digitalRead(BlueLed_Pin));
        delay(300);
    }
    digitalWrite(GreenLed_Pin, HIGH);
    digitalWrite(RedLed_Pin, HIGH);
    digitalWrite(BlueLed_Pin, HIGH);

    setupDisplay();
}
