Xinyuan-LilyGO/T-Echo/examples/PDMSerialPlotter/PDMSerialPlotter.ino

/*
  This example reads audio data from the on-board PDM microphones, and prints
  out the samples to the Serial console. The Serial Plotter built into the
  Arduino IDE can be used to plot the audio data (Tools -> Serial Plotter)

  Please try with the Circuit Playground Bluefruit

  This example code is in the public domain.
*/

#include <PDM.h>

// buffer to read samples into, each sample is 16-bits
short sampleBuffer[256];

// number of samples read
volatile int samplesRead;
int data_ = 6;
int clk  = 8;
#define GPIO15_Pin 15
void setup()
{
    Serial.begin(9600);
    while (!Serial);
    pinMode(GPIO15_Pin, OUTPUT);
    digitalWrite(GPIO15_Pin, LOW);
    PDM.setPins(data_, clk, -1);
    // configure the data receive callback
    PDM.onReceive(onPDMdata);

    // optionally set the gain, defaults to 20
    PDM.setGain(30);

    // initialize PDM with:
    // - one channel (mono mode)
    // - a 16 kHz sample rate
    if (!PDM.begin(1, 16000)) {
        Serial.println("Failed to start PDM!");
        while (1);
    }
}

void loop()
{
    // wait for samples to be read
    if (samplesRead) {
        // print samples to the serial monitor or plotter
        for (int i = 0; i < samplesRead; i++) {
            Serial.println(sampleBuffer[i]);
        }
        // clear the read count
        samplesRead = 0;
    }
}

void onPDMdata()
{
    // query the number of bytes available
    int bytesAvailable = PDM.available();

    // read into the sample buffer
    int si = PDM.read(sampleBuffer, bytesAvailable);
    Serial.print("**************si***********");
    Serial.println(si);
    // 16-bit, 2 bytes per sample
    samplesRead = bytesAvailable / 2;
}
