Xinyuan-LilyGO/T-Echo/examples/Factory/FreePuhuiti12pt7b.h

const uint8_t FreePuhuiti12pt7bBitmaps[] PROGMEM = {
    0x00, 0xAA, 0xAA, 0xAA, 0x0F, 0x99, 0x99, 0x99, 0x90, 0x02, 0x10, 0x10,
    0x40, 0x41, 0x01, 0x08, 0xFF, 0xFC, 0x20, 0x80, 0x82, 0x02, 0x10, 0x18,
    0x40, 0x41, 0x0F, 0xFF, 0xC4, 0x20, 0x30, 0x80, 0x82, 0x02, 0x08, 0x08,
    0x60, 0x08, 0x04, 0x02, 0x07, 0xE4, 0x84, 0x42, 0x21, 0x10, 0x88, 0x34,
    0x0F, 0x01, 0x60, 0x98, 0x44, 0x22, 0x11, 0x08, 0x84, 0xBF, 0x81, 0x00,
    0x80, 0x40, 0x20, 0x78, 0x08, 0xCC, 0x10, 0x84, 0x10, 0x84, 0x20, 0x84,
    0x60, 0x84, 0x40, 0xCC, 0x80, 0x78, 0xBE, 0x01, 0x22, 0x02, 0x41, 0x02,
    0x41, 0x04, 0x41, 0x04, 0x41, 0x08, 0x41, 0x10, 0x22, 0x10, 0x3E, 0x07,
    0x80, 0x23, 0x01, 0x04, 0x04, 0x10, 0x10, 0x40, 0x42, 0x00, 0xB0, 0x07,
    0x00, 0x36, 0x09, 0x0C, 0x28, 0x19, 0x20, 0x24, 0x80, 0x63, 0x00, 0x86,
    0x0D, 0x07, 0xC3, 0xFE, 0x11, 0x22, 0x44, 0x48, 0x88, 0x88, 0x88, 0x88,
    0x44, 0x42, 0x23, 0x10, 0x8C, 0x44, 0x22, 0x21, 0x11, 0x11, 0x11, 0x11,
    0x22, 0x24, 0x48, 0x80, 0x10, 0x22, 0x4B, 0xE3, 0x85, 0x11, 0x00, 0x04,
    0x00, 0x80, 0x10, 0x02, 0x00, 0x41, 0xFF, 0xC1, 0x00, 0x20, 0x04, 0x00,
    0x80, 0x10, 0x02, 0x00, 0x24, 0xA5, 0x00, 0xFC, 0xF0, 0x02, 0x04, 0x10,
    0x20, 0x81, 0x02, 0x08, 0x10, 0x20, 0x81, 0x02, 0x08, 0x10, 0x20, 0x81,
    0x00, 0x1F, 0x04, 0x11, 0x01, 0x20, 0x28, 0x03, 0x00, 0x60, 0x0C, 0x01,
    0x80, 0x30, 0x06, 0x00, 0xC0, 0x14, 0x04, 0x80, 0x88, 0x20, 0xF8, 0x3E,
    0x42, 0x10, 0x84, 0x21, 0x08, 0x42, 0x10, 0x84, 0x21, 0x7E, 0x00, 0x40,
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
    {   613,   8,  16,  11,    2,  -15 },   // 0x46 'F'
    {   629,  12,  16,  16,    2,  -15 },   // 0x47 'G'
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

const GFXfont FreePuhuiti12pt7b PROGMEM = {
    (uint8_t *)FreePuhuiti12pt7bBitmaps,
    (GFXglyph *)FreePuhuiti12pt7bGlyphs,
    0x20, 0x7E, 32
};

// Approx. 2343 bytes
