Xinyuan-LilyGO/T-Echo/examples/Factory/FreePuhuiti7pt7b.h

const uint8_t FreePuhuiti7pt7bBitmaps[] PROGMEM = {
    0x00, 0xFF, 0x40, 0xB6, 0xD0, 0x12, 0x12, 0x22, 0xFF, 0x24, 0x24, 0xFF,
    0x48, 0x48, 0x48, 0x21, 0x1D, 0x4A, 0x51, 0x87, 0x29, 0x4B, 0xE2, 0x10,
    0x62, 0x49, 0x25, 0x12, 0x86, 0xB0, 0x64, 0x52, 0x29, 0x24, 0xA1, 0x80,
    0x38, 0x22, 0x11, 0x09, 0x03, 0x02, 0x8A, 0x25, 0x0C, 0x86, 0x3C, 0xC0,
    0xF0, 0x29, 0x29, 0x24, 0x92, 0x24, 0x40, 0x89, 0x22, 0x49, 0x25, 0x25,
    0x00, 0x25, 0x5C, 0xA0, 0x10, 0x20, 0x47, 0xF1, 0x02, 0x04, 0x00, 0x6A,
    0xF0, 0x80, 0x11, 0x22, 0x24, 0x44, 0x88, 0x80, 0x79, 0x28, 0x61, 0x86,
    0x18, 0x61, 0x89, 0xE0, 0xE4, 0x92, 0x49, 0x24, 0x78, 0x08, 0x10, 0x20,
    0x41, 0x04, 0x10, 0x41, 0xFC, 0x78, 0x10, 0x43, 0x70, 0x30, 0x41, 0x07,
    0xE0, 0x0C, 0x28, 0x51, 0x24, 0x48, 0xBF, 0x82, 0x04, 0x08, 0x7A, 0x08,
    0x3C, 0x0C, 0x10, 0x41, 0x0F, 0xE0, 0x39, 0x04, 0x2E, 0xC6, 0x18, 0x61,
    0x85, 0xE0, 0xFC, 0x10, 0x82, 0x10, 0x42, 0x08, 0x41, 0x00, 0x7A, 0x18,
    0x61, 0x7B, 0x38, 0x61, 0x85, 0xE0, 0x7A, 0x18, 0x61, 0x85, 0xF0, 0x42,
    0x09, 0xC0, 0x81, 0x40, 0x05, 0xA0, 0x02, 0x18, 0xC6, 0x04, 0x07, 0x01,
    0x80, 0xFE, 0x00, 0x07, 0xF0, 0x80, 0xC0, 0x60, 0x30, 0xC6, 0x30, 0x00,
    0xF8, 0x10, 0x41, 0x08, 0xC2, 0x08, 0x00, 0x80, 0x0F, 0x86, 0x09, 0x01,
    0xA6, 0x99, 0x33, 0x44, 0x68, 0x8D, 0x12, 0x9D, 0x88, 0x01, 0x80, 0x0F,
    0x80, 0x08, 0x18, 0x24, 0x24, 0x24, 0x42, 0x7E, 0x42, 0x81, 0x81, 0xFA,
    0x18, 0x61, 0xFA, 0x38, 0x61, 0x87, 0xE0, 0x3E, 0x82, 0x04, 0x08, 0x10,
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
    {   249,   5,  10,   7,    1,   -9 },   // 0x46 'F'
    {   256,   7,  10,   9,    1,   -9 },   // 0x47 'G'
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

const GFXfont FreePuhuiti7pt7b PROGMEM = {
    (uint8_t *)FreePuhuiti7pt7bBitmaps,
    (GFXglyph *)FreePuhuiti7pt7bGlyphs,
    0x20, 0x7E, 19
};

// Approx. 1325 bytes
