Xinyuan-LilyGO/T-Echo/examples/Factory/FreePuhuiti9pt7b.h

const uint8_t FreePuhuiti9pt7bBitmaps[] PROGMEM = {
    0x00, 0xFF, 0xC8, 0xB6, 0xDA, 0x08, 0x82, 0x20, 0x88, 0x42, 0xFF, 0xC4,
    0x41, 0x10, 0x84, 0xFF, 0xC8, 0x82, 0x21, 0x08, 0x44, 0x00, 0x10, 0xFB,
    0x44, 0x89, 0x12, 0x14, 0x1C, 0x16, 0x24, 0x48, 0x91, 0x7F, 0x84, 0x08,
    0x10, 0x70, 0x48, 0x88, 0x88, 0x88, 0x90, 0x8A, 0x08, 0xA0, 0x74, 0xE0,
    0x51, 0x09, 0x10, 0x91, 0x11, 0x11, 0x11, 0x20, 0xE0, 0x1C, 0x08, 0x82,
    0x20, 0x88, 0x24, 0x06, 0x03, 0x01, 0x22, 0x84, 0xA0, 0xC8, 0x31, 0x0E,
    0x3C, 0xC0, 0xF8, 0x22, 0x44, 0x48, 0x88, 0x88, 0x88, 0x84, 0x44, 0x22,
    0x44, 0x22, 0x21, 0x11, 0x11, 0x11, 0x12, 0x22, 0x44, 0x21, 0x3E, 0xC5,
    0x00, 0x08, 0x04, 0x02, 0x01, 0x0F, 0xF8, 0x40, 0x20, 0x10, 0x08, 0x00,
    0x24, 0xA8, 0xF8, 0x80, 0x04, 0x20, 0x82, 0x10, 0x41, 0x08, 0x21, 0x04,
    0x10, 0x82, 0x00, 0x3C, 0x42, 0xC3, 0x81, 0x81, 0x81, 0x81, 0x81, 0x81,
    0x81, 0x83, 0x42, 0x3C, 0x79, 0x11, 0x11, 0x11, 0x11, 0x11, 0x10, 0x7C,
    0x06, 0x02, 0x02, 0x02, 0x02, 0x04, 0x0C, 0x08, 0x10, 0x20, 0xC0, 0xFF,
    0x7C, 0x0C, 0x08, 0x10, 0x20, 0x9E, 0x02, 0x02, 0x04, 0x08, 0x2F, 0x80,
    0x06, 0x03, 0x02, 0x82, 0x41, 0x21, 0x11, 0x08, 0x84, 0x82, 0x7F, 0xC0,
    0x80, 0x40, 0x20, 0x7D, 0x02, 0x04, 0x08, 0x1F, 0x01, 0x01, 0x02, 0x04,
    0x08, 0x2F, 0x80, 0x0C, 0x30, 0x40, 0x40, 0xBC, 0xC2, 0x81, 0x81, 0x81,
    0x81, 0x81, 0x42, 0x3C, 0xFF, 0x01, 0x02, 0x02, 0x04, 0x04, 0x04, 0x08,
    0x08, 0x10, 0x10, 0x20, 0x20, 0x3C, 0xC3, 0x81, 0x81, 0x81, 0x42, 0x3C,
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
    {   388,   7,  13,   9,    2,  -12 },   // 0x46 'F'
    {   400,   9,  13,  11,    1,  -12 },   // 0x47 'G'
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

const GFXfont FreePuhuiti9pt7b PROGMEM = {
    (uint8_t *)FreePuhuiti9pt7bBitmaps,
    (GFXglyph *)FreePuhuiti9pt7bGlyphs,
    0x20, 0x7E, 24
};

// Approx. 1704 bytes
