Xinyuan-LilyGO/T-Echo/examples/Sleep_Display/Display_Fonts.h

/*
 * @Description: None
 * @Author: LILYGO_L
 * @Date: 2024-08-10 10:08:12
 * @LastEditTime: 2024-08-13 16:25:03
 * @License: GPL 3.0
 */
#pragma once

#include "Fonts/FreeMono9pt7b.h"
#include "Fonts/FreeMonoBold9pt7b.h"

#include "Fonts/FreeSans9pt7b.h"
#include "Fonts/FreeSans12pt7b.h"
#include "Fonts/FreeSans18pt7b.h"
#include "Fonts/FreeSans24pt7b.h"
#include "Fonts/FreeSansOblique9pt7b.h"
#include "Fonts/FreeSansOblique12pt7b.h"
#include "Fonts/FreeSansOblique18pt7b.h"
#include "Fonts/FreeSansOblique24pt7b.h"
#include "Fonts/FreeSansBold9pt7b.h"
#include "Fonts/FreeSansBold12pt7b.h"
#include "Fonts/FreeSansBold18pt7b.h"
#include "Fonts/FreeSansBold24pt7b.h"
#include "Fonts/FreeSansBoldOblique9pt7b.h"
#include "Fonts/FreeSansBoldOblique12pt7b.h"
#include "Fonts/FreeSansBoldOblique18pt7b.h"
#include "Fonts/FreeSansBoldOblique24pt7b.h"

#include "Fonts/Org_01.h"
