Xinyuan-LilyGO/T-Echo/(commit log)

2022-04-29 README: update adafruit boards json
    Source from https://learn.adafruit.com/add-boards-arduino-v164/setup. The previous URL 404s.
2022-05-06 perfect：Meshtastic_firmware
2022-05-06 perfect：button functions
2022-05-12 perfect：Use platformio.ini to download the firmware through the USB port
2022-05-24 feature/LoRaWAN: Add lorawan test program
    This is a simple lorawan test program that needs to replace the
    original sx1262 module with sx1276.
    [utilities.h]
2022-06-08 perfect：image
2022-06-23 perfect： softrf
2022-06-28 docs： L76k enchirdion
2022-07-20 test：sleep
2022-07-25 perfect：LoRa Precautions for setting output power
2022-09-23 test：A7682
2024-09-05 fix pio complie error
    [LoraReceive.ino, LoraTransmit.ino, utilities.h]
2024-09-09 Update low-power test examples
2025-04-08 Added sensor examples
2025-04-15 Factory Example Optimizing Power Consumption
2025-05-10 nRF52 internal pull down resistors are not strong enough to counter internal pull up resistors of L76K WAKE UP pin
2025-06-24 Added sensor dxf
    [T-BHI260-ICM29048.dxf]
2025-07-14 Update schematic
2025-07-28 Added Factory example support motor , buzzer function
    [main.cpp, utilities.h]
2025-07-28 Add CURRENT.UF2
2025-11-03 Added sensor sch
